Stephan2204/HM-WIRED-ESP32/HM-WIRED-ESP32.ino

#include <Arduino.h>
#include <WiFi.h>
#include <ETH.h>
#include <Network.h>
#include <ESPmDNS.h>
#include <WebServer.h>
#include <Preferences.h>
#include <PubSubClient.h>
#include <Update.h>
#include <nvs.h>
#include <esp_system.h>
#include <time.h>
#include <sys/time.h>
#include <esp_sntp.h>
#include <lwip/ip_addr.h>

HardwareSerial HM485(2);
WebServer webServer(80);
Preferences preferences;
WiFiClient wifiClient;
PubSubClient mqttClient(wifiClient);

// ============================================================
// HM485 PROJECT NOTES / RESEARCH LOG (v0.7.45)
//
// v0.7.43 NEW EVIDENCE / PURPOSE
// - v0.7.42b with A/B connected: every active DBA7/FB probe produced one 0x00
//   roughly one UART character time (~590 us) after DIR was released to RX.
// - v0.7.42b with A/B physically disconnected: 0 RX bytes in all hold-high and
//   turnaround tests. Therefore the 0x00 is bus-side dependent, not a purely local
//   ESP32 UART FIFO echo.
// - Turnaround delays 0..100 us and a 1500 us TX hold did not change the result.
// - v0.7.43 therefore observes GPIO35 (SP485 RO -> ESP32 RX) directly after DIR LOW.
//   It records logic transitions and longest LOW/HIGH runs for 1800 us, then drains
//   the UART FIFO. This distinguishes a real serial byte from a BREAK/long-low or
//   other electrical waveform without depending on HardwareSerial error reporting.
// - IMPORTANT: GPIO sampling is diagnostic only; normal parser/network/MQTT behavior
//   remains based on the stable v0.7.40 lineage.
// ============================================================
//
// IMPORTANT BASELINE
// ------------------
// v0.7.40 is the last known-good normal gateway baseline. It added the
// permanent web-switchable RAW RX ONLY mode. In that mode DIR is forced
// LOW (receive), all WT32 HM485 TX is inhibited, the protocol parser is
// bypassed and every UART byte is logged with timing. KEEP THIS FEATURE
// in all future versions: it is our built-in passive bus analyzer.
//
// HARDWARE / ELECTRICAL FINDINGS
// ------------------------------
// - WT32-ETH01: RX GPIO35, TX GPIO17, DIR GPIO33.
// - Current transceiver is SP485 with DE and /RE controlled together by
//   DIR. The earlier MAX485 setup was replaced during troubleshooting.
// - RX is proven good on the real production bus. v0.7.39 RX-only saw
//   reproducible structured HM485 traffic from real switches and hm485d.
// - Therefore A/B polarity, RX wiring, UART RX pin and 19200 baud work.
// - An isolated self-TX often leaves one 0x00 after TX->RX; treat it as a
//   local turnaround/transceiver artifact unless proven otherwise.
//
// DISCOVERY FINDINGS SO FAR
// -------------------------
// 1. hm485d discovery is a 32-bit tree/prefix search, not a conventional
//    brute-force scan. Passive capture saw 00000000/03, /0B ... /7B, then
//    branches such as 00008000/83, 0000C000/8B and finally
//    the final 32-bit branch split for a known device.
// 2. The user's subnetting analogy is a very useful model: DST is the
//    address/prefix under test and CTRL carries the prefix depth (valid
//    bits). A positive response means at least one device exists below
//    that branch. Exact bit mapping still has to be documented/proven.
// 3. Working hm485d discovery repeats negative/ambiguous probes up to three
//    times. Passive captures show ~20 ms retry timing and progressive tree
//    descent after positive responses.
// 4. Exact hm485d-style discovery frame generation is implemented here:
//    start FD, 4-byte DST, CTRL, no sender for discovery, length 02, CRC16,
//    FC escaping. Known captured frames validated the CRC implementation.
//    FD 00 00 DB A7 FB 02 F8 1A.
// 5. Earlier low-level observations saw raw 0xF8 around known positive
//    prefixes all the way to complete 32-bit device addresses.
// 6. v0.7.41 replayed the complete captured hm485d branch while A/B were
//    still wired with the wrong polarity. All 73 probes produced only 0x00.
//    This result is now INVALID as a protocol conclusion because the later
//    electrical tests proved the bus polarity was wrong for active TX/RX.
// 7. v0.7.42b/.43 isolated that 0x00 electrically. With A/B disconnected
//    it vanished; GPIO35 showed a long invalid level rather than a UART
//    discovery byte. After swapping A/B, the normal active read-only scan
//    works completely: TYPE, SERIAL, FW, EEPROM and STATUS replies are valid
//    for all three known devices. Therefore the current A/B polarity and the
//    normal bidirectional RS485 path are now proven.
// 8. v0.7.44 deliberately returns to the deterministic captured hm485d
//    prefix replay, now with the CORRECT proven A/B polarity. It returned
//    valid F8/F0 positive reactions and 00 negative reactions all the way to
//    a known full-address leaf. v0.7.45 replaced replay with the native full tree.
//    Any non-zero raw reaction is logged; F8 remains counted separately.
//
// v0.7.45 DISCOVERY MILESTONE (PROVEN)
// ------------------------------------
// - Replace the deterministic DBA7 replay with the complete native hm485d
//   32-bit prefix/tree traversal.
// - Start at address 00000000 with validBits=1 and 3 tries per negative prefix.
// - Use CTRL=((validBits-1)<<3)|0x03 exactly like HM485_Protocol.pm.
// - Decide each probe only from the FIRST raw RX byte: 00 = negative; any
//   non-zero byte (normally F8, occasionally observed F0) = positive.
// - Preserve the 20 ms hm485d discovery timeout/step cadence and 600 ms
//   continuous idle guard before starting.
// - On validBits==33, record the full 32-bit device address and continue the
//   tree exactly as hm485d does.
// - After discovery finishes, automatically run the proven READ-ONLY
//   TYPE/SERIAL/FW/EEPROM/STATUS scan against the discovered address list.
// - v0.7.46 retires the fixed TEST_DEVICES runtime fallback. Native discovery
//   is now the normal boot path and the authoritative live address source.

// v0.7.46 CLEANUP / NORMAL-OPERATION STEP
// ----------------------------------------
// - Native discovery starts automatically at boot after 600 ms continuous idle.
// - Normal Serial output is compact: start, FOUND addresses, finish summary,
//   TYPE, SERIAL and FW. Per-prefix discovery, EEPROM dumps and per-channel
//   STATUS lines are disabled by default to reduce jitter and console flooding.
// - Detailed discovery/file and scan logging can be re-enabled with the
//   compile-time flags DISCOVERY_VERBOSE_* / SCAN_VERBOSE_*.
// - EEPROM and STATUS are still queried and processed; only their Serial
//   presentation is quiet. MQTT/state processing remains unchanged.
// - Runtime TEST_DEVICES fallback is retired; discovery results are authoritative.
//
// v0.7.50a POLISH / OPERATIONS
// ---------------------------
// - Persistent German/English selection for the primary web UI. Language never
//   changes MQTT topics, serial-number based object identity or HA unique_id.
// - Common top navigation reduces duplicated buttons and separates normal
//   operation from diagnostics/firmware pages.
// - Authenticated backup export/import for gateway configuration and currently
//   known device metadata (friendly names, profiles, inversion). Backup contains
//   credentials and therefore must be handled as a secret. Discovery remains
//   authoritative after restore.
//
// v0.8.0 OUTPUT CONTROL MILESTONE
// --------------------------------
// - First deliberately write-capable release. The proven v0.7.51 read path,
//   native discovery, RAW RX ONLY hard inhibit and address-conflict guard remain.
// - HMW-IO-12-Sw14-DR digital outputs can be exposed as HA/MQTT Switch or Button.
// - Wire command confirmed from passive FHEM captures: 73 <bus-channel> <value16>,
//   with OFF=0x0000 and ON=0x03FF. Device INFO_LEVEL reply is 69 <ch> <value>.
// - Output writes use bus-idle arbitration and up to three attempts total. A matching
//   INFO_LEVEL reply confirms state; an ACK-only reply is accepted and followed by
//   a status refresh. Failed writes never publish an optimistic state.
// - Button profile supports configurable pulse duration and resting state OFF/ON.
// - Analog/frequency 0..1023 encoding has been observed but is intentionally NOT
//   exposed for writing yet. EEPROM writes remain disabled.
// - Coexistence with another central (for example FHEM 00000001 while this gateway
//   uses 00000002) remains experimental and must be tested carefully.
//
// v0.8.1 WRITE/ACK FIX
// --------------------
// - Fix critical output transaction bug: an active output write no longer blocks
//   sendAck(). Device INFO_LEVEL I-frames are ACKed immediately in the normal
//   parser before output application logic runs. This prevents the device from
//   retransmitting the same 0x69 frame after the missing ACK timeout.
// - AUTO now resolves to OUTPUT_SWITCH for physically known digital outputs.
//   Existing persisted AUTO profiles therefore become switches without NVS migration.


// v0.9.3g5 RELIABILITY / NTP LOGGING
// -----------------------------------
// - Web diagnostic log now keeps monotonic uptime and, after NTP sync, also
//   prepends real local Europe/Berlin timestamps with milliseconds.
// - NTP server is configurable in the web UI. DHCP option 42 can be preferred;
//   a configured manual server remains the fallback. DHCP-NTP is armed from the
//   ETH/WiFi START event, after the TCP/IP stack exists but before the DHCP lease.
// - IMPORTANT g5 fix: SNTP is never initialized before ETH.begin(); this avoids
//   the LAN8720 crash/reboot loop possible in g4.
// - Button output starts rejected by a temporary poll/pending transaction are
//   no longer discarded. They remain queued and retry every 50 ms for up to 10 s.

// GENERAL PROJECT ROADMAP (KEEP THIS SECTION IN FUTURE VERSIONS)
// --------------------------------------------------------------
// DISCOVERY / BUS CORE
// [x] Prove electrical TX/RX path and correct A/B polarity; active reads now work.
// [x] DST+CTRL prefix/valid-bit mapping proven by native full-tree discovery.
// [x] Positive discovery reaction: first RX byte != 0 (hm485d semantics; v0.7.44 verified F8/F0).
// [x] v0.7.45: native hm485d-compatible 32-bit discovery tree implemented.
// [x] v0.7.46: discovered addresses exclusively drive scan/poll; fixed runtime list retired.
// [x] Native discovery automatically hands off to TYPE/SERIAL/FW/EEPROM/STATUS scan.
// [ ] Detect devices appearing/disappearing and expose online/last-seen state.
//
// PASSIVE OPERATION / LEARNING
// [ ] Preserve passive event snooping as the preferred fast state-update path.
// [ ] Passively recognize previously unknown device addresses seen on the bus.
// [ ] Learn/validate channel activity and useful telegram types from traffic.
// [ ] Keep periodic active read-only polling only as a safety/fallback refresh.
// [ ] Keep permanent RAW RX ONLY hard-TX-inhibit mode in every future build.
//
// DEVICE / PORT PROFILE MODEL
// [ ] Build semantic per-channel profiles on top of physical HM485 channels.
// [ ] Profiles planned/needed include at least: Window/door contact, shutter/
//     roller shutter (cover), alarm/contact, switch/light, push button, generic
//     binary input, analog/frequency sensor and generic/raw fallback.
// [ ] Where possible derive electrical/channel capability automatically from
//     device type + EEPROM; allow user override of semantic purpose.
// [ ] Map profiles to correct Home Assistant entity domain/device_class, e.g.
//     binary_sensor, switch, cover, sensor rather than exposing raw channels.
//
// NAMING / CONFIGURATION / PERSISTENCE
// [ ] User-editable friendly name for every device.
// [x] v0.7.47: user-editable friendly name and semantic profile per channel/port.
// [ ] Store names, profile selections, discovered-device metadata and relevant
//     gateway settings persistently in ESP32 NVS (Preferences).
// [ ] Keep configuration across reboot/OTA; design versioned/migratable NVS
//     schema before large numbers of installations/config entries exist.
// [x] v0.7.47: web UI for device/channel naming and profile assignment.
// [x] v0.7.48: per-channel NO/NC inversion, status page, configurable own address.
// [x] v0.7.49: passive address-1 detection + duplicate-own-address TX lock; status shows inversion.
// [x] v0.7.50a: persistent German / English web UI selection.
// [x] v0.7.50a: authenticated config/profile backup export + restore import.
//
// MQTT / HOME ASSISTANT
// [ ] Retained state topics + LWT/availability for gateway and devices.
// [ ] Generate HA MQTT Discovery from the semantic channel profile and names.
// [ ] Update HA immediately from passive bus events; polling is fallback only.
// [ ] Republish discovery/state after MQTT reconnect without duplicate entities.
// [ ] Keep stable unique_ids even if friendly names are changed later.
//
// WRITE / CONTROL - ONLY AFTER READ PATH IS PROVEN
// [ ] Stay READ-ONLY during discovery/profile development.
// [ ] Later add explicit safe switching/control for supported output profiles.
// [ ] Add cover/shutter command semantics only after telegrams are understood.
// [ ] EEPROM writes/configuration only with explicit safeguards, verification,
//     backups and no accidental writes during discovery or passive learning.
// [ ] Separate read-only diagnostics from write-capable operating mode clearly.
//
// PLATFORM / OPERATIONS (ALREADY PRESENT; MUST NOT REGRESS)
// [ ] Ethernet primary on WT32-ETH01; Wi-Fi fallback/setup AP.
// [ ] Web configuration in NVS, HTTP Basic Auth, diagnostics/log page.
// [ ] MQTT, Home Assistant Discovery, retained states and gateway diagnostics.
// [ ] Web OTA firmware update; keep a recoverable serial-flash path.
// [ ] Preserve bus statistics: RX/TX, CRC errors, timeouts, retries, last-seen.
// [ ] Keep experimental/research notes in source until native discovery and
//     stable production operation are proven, so findings are not forgotten.
//
// ============================================================
// HM485 Gateway v0.7.8
//
// Base: v0.5.3a HM485 READ-ONLY core
//
// New:
// - v0.7.46: native discovery runs automatically at boot.
// - Quiet normal logging: discovery probe-by-probe output disabled; status and
//   EEPROM data no longer flood Serial. TYPE/SERIAL/FW remain visible.
// - Fixed TEST_DEVICES list retired from runtime device selection.
//   - WiFi station + fallback setup AP
//   - Web configuration stored in NVS
//   - MQTT + retained states + LWT
//   - Home Assistant MQTT Discovery
//   - Passive HM485 status/event snooping -> immediate MQTT
//   - Periodic read-only status refresh (5 min safety net)
//   - Gateway itself appears as a Home Assistant MQTT device
//   - Gateway diagnostics: firmware, IP, RSSI, uptime, devices,
//     RX/TX frames, CRC errors, timeouts and retries
//   - WT32-ETH01 Ethernet primary + WiFi fallback
//   - Web firmware update (OTA)
//   - HTTP Basic Auth for configuration / OTA
//   - Protected Web Log / Diagnosis page
//   - Optional raw HM485 RX/TX logging in RAM
//   - Native HM485 Discovery diagnostics
//   - Discovery probes grouped as xN
//   - Reactions / CRC errors / incomplete frames correlated to last probe
//   - WT32 sends no HM485 requests while analyzer is active
//
// WT32-ETH01 HM485 wiring:
// GPIO35 = RX <- RO
// GPIO17 = TX -> DI
// GPIO33 = DIR -> RTS / DE+/RE
//
// WT32 Ethernet/LAN8720:
// GPIO16 = PHY oscillator enable
// GPIO18 = MDIO
// GPIO23 = MDC
// GPIO0  = 50 MHz REFCLK input
//
// ESP HM485 address : 00000002
// FHEM central      : 00000001
//
// IMPORTANT:
//   HM485 is still READ ONLY.
//   No output switching and no EEPROM writes.
// ============================================================

// v0.8.2:
// - Data-driven device profile registry for official HMW and selected HBW devices.
// - Explicit support state: tested / known-untested / experimental.
// - Untested/HBW profiles are recognition-only by default: no write enable.
// - Existing tested HMW-IO-12-Sw14-DR write path remains enabled by default.
// v0.9.2:
// - Passive discovery: a CRC-valid frame from a previously unknown device address
//   (> 0x000000FF) schedules automatic identification at the next safe bus-idle slot.
// - Optional experimental runtime writes for documented classic/HBW switch actors.
// v0.9.3g3: HBW-1W-T10 invalid temperatures <= -270.00 degC publish an empty MQTT payload
// so Home Assistant numeric temperature sensors become unknown instead of keeping a bogus value.
// v0.9.3g2: HBW-Sen-EP (0x84) real/source-verified counter payload is
// 69 <channel> <uint16_be>. Counter channels are exposed to HA as numeric
// sensors with state_class=total_increasing and unit 'impulses'. Active polling
// remains disabled for now; passive broadcasts are sufficient for this test.
// v0.9.3g1: compile-order fix: forgetDevice() moved behind transaction
// globals and MQTT forward declarations. No functional changes.
// v0.9.3g: persistent device registry + boot restore/verification, explicit
// 'forget device' action with retained HA discovery cleanup, and extended ESP32
// system diagnostics (chip/RAM/flash/sketch/reset reason). Existing hm485meta
// records are auto-migrated into the registry by enumerating NVS once.
// v0.9.3f4: HBW MQTT resync fix. Every complete 0x41 identity announcement
// now refreshes HA discovery/output subscriptions even when metadata is unchanged.
// A completed targeted HBW status poll republishes retained states as a final
// synchronization pass. This fixes stale HA state and missing /set subscription
// after gateway/HBW restart ordering.
// v0.9.3f3: compile fix: forward declaration of
// processPassiveIdentityStatusPoll() now matches its static definition.
// v0.9.3f2: every HBW 0x41 identity/boot announcement now queues a targeted
// one-shot status poll for that device when activeReadSafe=true. This also
// runs when identity metadata is unchanged, fixing stale HA states after an
// HBW-LC-Sw8 reboot. The queued poll waits for a safe idle bus slot.
// v0.9.3f1: compile/link fix for Arduino auto-prototype const mismatch in
// runtimePollDeviceCount()/runtimePollDeviceAddress(). No protocol changes.
// v0.9.3f: status polling now iterates the runtime device database instead of
// native-discovery-only addresses, so passive HBW devices can be polled when
// their profile explicitly marks active reads safe. HBW-LC-Sw8 is polled via
// 53 ch immediately after its 0x41 identity announcement. HBW-Sen-EP (0x84)
// remains passive-only with eight UINT24 counter channels prepared for testing.
// v0.9.3e: HBW-LC-Sw8 original source verified: LEVEL_SET 78 ch 00/C8,
// LEVEL_GET 53 ch, INFO_LEVEL 69 ch level 00. Active polling enabled.
// 0.9.3d's incorrect 0x69 write path has been removed.
// v0.9.3d: HBW-LC-Sw8 real protocol: 69 ch 00/C8, ACK confirms write;
// overview now shows known state values / nominal channel count.
// v0.9.3c: nominal HBW channel count is independent of active-read safety;
// fixes Web UI channel count and MQTT command subscriptions for HBW actors.
// v0.9.3b: HBW 0x41 identity is learned only in the existing passive
// broadcast path; native discovery remains byte-for-byte/timing unchanged.
// v0.9.3: real HBW support: HBW-1W-T10 (0x81) temperatures and
// HBW-LC-Sw8 (0x83) eight switch channels enabled for hardware verification.
//   Disabled by default and deliberately separate from EEPROM/config support.
//
static constexpr const char *FW_VERSION = "0.9.3g5";

// ============================================================
// Hardware / HM485
// ============================================================

static constexpr int HM485_RX_PIN  = 35;
static constexpr int HM485_TX_PIN  = 17;
static constexpr int HM485_DIR_PIN = 33;
static constexpr uint32_t HM485_BAUD = 19200;

static constexpr uint32_t DEFAULT_LOCAL_ADDRESS = 0x00000001;
static constexpr uint32_t FHEM_ADDRESS  = 0x00000001;

// v0.7.47: no fixed HM485 device addresses are compiled into normal runtime.
// The live device list comes exclusively from native HM485 discovery.

static constexpr uint8_t FRAME_START_LONG  = 0xFD;
static constexpr uint8_t FRAME_START_SHORT = 0xFE;
static constexpr uint8_t ESCAPE_CHAR       = 0xFC;

static constexpr uint32_t BUS_IDLE_US             = 10000;
static constexpr uint32_t RESPONSE_TIMEOUT_MS     = 500;
static constexpr uint32_t REQUEST_GAP_MS          = 100;
static constexpr uint8_t  MAX_REQUEST_RETRIES     = 2;
static constexpr uint32_t STATUS_REFRESH_MS       = 300000;
static constexpr uint32_t MQTT_RECONNECT_MS       = 5000;
static constexpr uint32_t WIFI_CONNECT_TIMEOUT_MS = 15000;
static constexpr uint32_t ETHERNET_FALLBACK_DELAY_MS = 8000;

// v0.7.49 address-collision guard. On every boot the gateway listens only
// before its first HM485 transmission. A source address equal to our own is
// latched as a conflict and keeps DE/TX disabled until the address is changed
// and the gateway is rebooted. Address 00000001 is also observed separately
// so parallel-test installations can see whether the regular central address
// is already active on the bus.
static constexpr uint32_t ADDRESS_GUARD_BOOT_LISTEN_MS = 8000;
static constexpr uint32_t ADDRESS_GUARD_OWN_TX_SUPPRESS_MS = 100;

// v0.7.47: normal operation is intentionally quiet. Detailed per-probe
// discovery logging was invaluable during reverse engineering, but Serial I/O
// and String formatting add jitter. Enable only for diagnostics.
static constexpr bool DISCOVERY_VERBOSE_SERIAL = false;
static constexpr bool DISCOVERY_VERBOSE_FILE   = false;
static constexpr bool SCAN_VERBOSE_STATUS      = false;
static constexpr bool SCAN_VERBOSE_EEPROM      = false;

static constexpr uint8_t  MAX_DEVICES      = 16;
static constexpr uint8_t  MAX_CHANNELS     = 32;
static constexpr uint16_t EEPROM_CACHE_SIZE = 64;

// ============================================================
// Network / MQTT configuration
// ============================================================

struct GatewayConfig
{
  String wifiSsid;
  String wifiPassword;

  String mqttHost;
  uint16_t mqttPort = 1883;
  String mqttUser;
  String mqttPassword;

  String mqttClientId = "hm485-gateway";
  String mqttBaseTopic = "hm485";
  String discoveryPrefix = "homeassistant";
  bool discoveryEnabled = true;

  // v0.9.2: allow runtime writes for documented but locally untested actuators.
  // Default OFF. EEPROM/config writes remain restricted independently.
  bool experimentalWritesEnabled = false;

  String hostname = "hm485-gateway";

  // NTP / clock. DHCP option 42 is preferred when enabled. If DHCP does not
  // supply an NTP server, ntpServer remains the configured fallback.
  bool ntpUseDhcp = true;
  String ntpServer = "";

  // HM485 address of this gateway/central. 00000001 is the regular central
  // address. Other addresses are intended for parallel operation/tests.
  uint32_t localAddress = DEFAULT_LOCAL_ADDRESS;

  // Web UI language. Values: "de" or "en".
  String uiLanguage = "de";

  // HTTP Basic Auth for configuration/OTA.
  String webUser = "admin";
  String webPassword = "hm485setup";
};

GatewayConfig config;

bool setupApActive = false;
String setupApSsid;

bool ethernetStarted = false;
bool wifiFallbackStarted = false;
bool lastEthernetReady = false;
uint32_t ethernetStartedMs = 0;

uint32_t wifiConnectStartedMs = 0;
uint32_t lastMqttReconnectMs = 0;
uint32_t lastGatewayDiagnosticsMs = 0;
static constexpr uint32_t GATEWAY_DIAGNOSTICS_MS = 30000;

// Europe/Berlin with automatic CET/CEST changeover.
static constexpr const char *NTP_TZ = "CET-1CEST,M3.5.0/2,M10.5.0/3";
volatile bool ntpSyncEventPending = false;
volatile bool ntpNetworkGotIpPending = false;
volatile bool ntpDhcpArmed = false;
bool ntpWasSynchronized = false;
bool ntpClientStarted = false;
uint32_t ntpIpReadyMs = 0;

// ============================================================
// HM485 address conflict protection (v0.7.49)
// ============================================================

bool addressGuardBootActive = false;
bool addressConflictLocked = false;
bool centralAddressOneSeen = false;

// Must be declared before web handlers that reference it.
static bool rawRxOnlyMode = false;
uint32_t addressGuardStartedMs = 0;
uint32_t addressConflictLastSeenMs = 0;
uint32_t centralAddressOneLastSeenMs = 0;
uint32_t lastLocalTxCompletedMs = 0;
uint32_t addressConflictSender = 0;

// v0.9.2 passive discovery. Unknown CRC-valid device senders are added as
// candidates and trigger a normal metadata scan once the bus is safely idle.
bool passiveDiscoveryScanPending = false;
uint32_t passiveDiscoveryLastCandidate = 0;

// ============================================================
// Channel model
// ============================================================

enum class ChannelType : uint8_t
{
  UNKNOWN,
  CONTACT,
  DIGITAL_OUTPUT,
  DIGITAL_ANALOG_OUTPUT,
  DIGITAL_INPUT,
  DIGITAL_FREQUENCY_INPUT,
  DIGITAL_ANALOG_INPUT,
  INPUT_OUTPUT,
  COVER,
  DIMMER,
  TEMPERATURE,
  COUNTER,
  KEY_INPUT,
  MOTION,
  RGB
};

enum class ChannelBehaviour : uint8_t
{
  UNKNOWN,
  CONTACT,
  DIGITAL_OUTPUT,
  ANALOG_OUTPUT,
  DIGITAL_INPUT,
  FREQUENCY_INPUT,
  ANALOG_INPUT
};

enum class SemanticProfile : uint8_t
{
  AUTO = 0,
  WINDOW,
  DOOR,
  ALARM,
  CONTACT,
  BINARY_INPUT,
  ANALOG_SENSOR,
  FREQUENCY_SENSOR,
  OUTPUT_MONITOR,
  SHUTTER_MONITOR,
  RAW_SENSOR,
  OUTPUT_SWITCH,
  OUTPUT_BUTTON,
  ANALOG_VOLTAGE_RAW,
  ANALOG_CURRENT_RAW,
  ANALOG_POWER_RAW,
  ANALOG_TEMPERATURE_RAW,
  ANALOG_RESISTANCE_RAW,
  ANALOG_PRESSURE_RAW
};

enum class ValueEncoding : uint8_t
{
  UNKNOWN,
  BOOLEAN_1BYTE,
  BOOLEAN_2BYTE,
  UINT16,
  UINT24
};

enum class PulseValueState : uint8_t
{
  UNAVAILABLE,
  VALID,
  SPECIAL
};

struct BehaviourEeprom
{
  bool available;
  uint16_t byteAddress;
  uint8_t firstBit;
  uint8_t bitStep;
};

struct ChannelProfile
{
  uint8_t first;
  uint8_t count;
  ChannelType type;
  ValueEncoding infoLevelEncoding;
  bool configurable;
  ChannelBehaviour defaultBehaviour;
  BehaviourEeprom behaviourEeprom;
};

enum class DeviceSupport : uint8_t
{
  TESTED,          // Real hardware tested with this gateway
  KNOWN_UNTESTED,  // Profile documented, but no real hardware test here yet
  EXPERIMENTAL     // Homebrew/partial profile; passive/basic recognition only
};

struct DeviceProfile
{
  uint16_t deviceType;
  const char *model;
  const char *family;
  uint16_t eepromSize;
  const ChannelProfile *channels;
  uint8_t channelGroupCount;
  uint8_t nominalChannelCount;
  DeviceSupport support;
  bool activeReadSafe;
  bool writeEnabled;
};

// ============================================================
// Profiles
// ============================================================

static constexpr ChannelProfile PROFILE_SEN_SC_12[] =
{
  { 0, 12, ChannelType::CONTACT, ValueEncoding::BOOLEAN_1BYTE, false,
    ChannelBehaviour::CONTACT, { false, 0, 0, 0 } }
};

static constexpr ChannelProfile PROFILE_IO12_SW14[] =
{
  { 0, 6,  ChannelType::DIGITAL_OUTPUT,          ValueEncoding::BOOLEAN_2BYTE, false, ChannelBehaviour::DIGITAL_OUTPUT, { false, 0, 0, 0 } },
  { 6, 8,  ChannelType::DIGITAL_ANALOG_OUTPUT,   ValueEncoding::UINT16,        true,  ChannelBehaviour::DIGITAL_OUTPUT, { true, 0x0007, 0, 1 } },
  { 14, 6, ChannelType::DIGITAL_FREQUENCY_INPUT, ValueEncoding::BOOLEAN_2BYTE, true,  ChannelBehaviour::DIGITAL_INPUT,  { true, 0x0009, 0, 1 } },
  { 20, 6, ChannelType::DIGITAL_ANALOG_INPUT,    ValueEncoding::UINT16,        true,  ChannelBehaviour::DIGITAL_INPUT,  { true, 0x0008, 0, 1 } }
};

// Generic/untested profile descriptions.  They intentionally do NOT enable
// active writing.  The purpose is recognition, sane HA defaults where safe,
// and a data-driven base for later verified implementations.
static constexpr ChannelProfile PROFILE_IO4_FM[] =
{
  { 0, 4, ChannelType::INPUT_OUTPUT, ValueEncoding::BOOLEAN_1BYTE, true,
    ChannelBehaviour::UNKNOWN, { false, 0, 0, 0 } }
};

static constexpr ChannelProfile PROFILE_SW2[] =
{
  { 0, 2, ChannelType::DIGITAL_OUTPUT, ValueEncoding::BOOLEAN_1BYTE, false,
    ChannelBehaviour::DIGITAL_OUTPUT, { false, 0, 0, 0 } }
};

static constexpr ChannelProfile PROFILE_IO12_SW7[] =
{
  { 0, 7,  ChannelType::DIGITAL_OUTPUT, ValueEncoding::BOOLEAN_1BYTE, false, ChannelBehaviour::DIGITAL_OUTPUT, { false, 0, 0, 0 } },
  { 7, 12, ChannelType::DIGITAL_INPUT,  ValueEncoding::UINT16, false, ChannelBehaviour::DIGITAL_INPUT,  { false, 0, 0, 0 } }
};

static constexpr ChannelProfile PROFILE_DIM1[] =
{
  { 0, 1, ChannelType::DIMMER, ValueEncoding::UINT16, false,
    ChannelBehaviour::UNKNOWN, { false, 0, 0, 0 } }
};

static constexpr ChannelProfile PROFILE_BL1[] =
{
  { 0, 1, ChannelType::COVER, ValueEncoding::UINT16, false,
    ChannelBehaviour::UNKNOWN, { false, 0, 0, 0 } }
};

static constexpr ChannelProfile PROFILE_IO12_FM[] =
{
  { 0, 12, ChannelType::INPUT_OUTPUT, ValueEncoding::UINT16, true,
    ChannelBehaviour::UNKNOWN, { false, 0, 0, 0 } }
};

// HBW-1W-T10, real hardware verified:
 // INFO_LEVEL: 69 <channel 0..9> <temperature MSB> <temperature LSB>
 // temperature is signed int16 big-endian in 0.01 degC.
 // 0x954D = -27315 = -273.15 degC marks an unassigned/missing 1-Wire sensor.
static constexpr ChannelProfile PROFILE_HBW_TEMP10[] =
{
  { 0, 10, ChannelType::TEMPERATURE, ValueEncoding::UINT16, false, ChannelBehaviour::UNKNOWN, { false, 0, 0, 0 } }
};
static constexpr ChannelProfile PROFILE_HBW_BL4[] =
{
  { 0, 4, ChannelType::COVER, ValueEncoding::UINT16, false, ChannelBehaviour::UNKNOWN, { false, 0, 0, 0 } }
};
static constexpr ChannelProfile PROFILE_HBW_BL8[] =
{
  { 0, 8, ChannelType::COVER, ValueEncoding::UINT16, false, ChannelBehaviour::UNKNOWN, { false, 0, 0, 0 } }
};
static constexpr ChannelProfile PROFILE_HBW_SW8[] =
{
  { 0, 8, ChannelType::DIGITAL_OUTPUT, ValueEncoding::BOOLEAN_1BYTE, false, ChannelBehaviour::DIGITAL_OUTPUT, { false, 0, 0, 0 } }
};
static constexpr ChannelProfile PROFILE_HBW_SW12[] =
{
  { 0, 12, ChannelType::DIGITAL_OUTPUT, ValueEncoding::BOOLEAN_1BYTE, false, ChannelBehaviour::DIGITAL_OUTPUT, { false, 0, 0, 0 } }
};
// HBW-Sen-EP (0x84): eight S0/pulse counters.
// Real bus traffic and the original source confirm a 16-bit counter value:
//   INFO_LEVEL: 69 <channel> <value_hi> <value_lo>
// Keep active polling disabled until separately tested on the real module.
static constexpr ChannelProfile PROFILE_HBW_COUNTER8[] =
{
  { 0, 8, ChannelType::COUNTER, ValueEncoding::UINT16, false, ChannelBehaviour::UNKNOWN, { false, 0, 0, 0 } }
};
static constexpr ChannelProfile PROFILE_HBW_KEY8[] =
{
  { 0, 8, ChannelType::KEY_INPUT, ValueEncoding::BOOLEAN_1BYTE, false, ChannelBehaviour::DIGITAL_INPUT, { false, 0, 0, 0 } }
};
static constexpr ChannelProfile PROFILE_HBW_KEY12[] =
{
  { 0, 12, ChannelType::KEY_INPUT, ValueEncoding::BOOLEAN_1BYTE, false, ChannelBehaviour::DIGITAL_INPUT, { false, 0, 0, 0 }
  }
};
static constexpr ChannelProfile PROFILE_HBW_MOTION2[] =
{
  { 0, 2, ChannelType::MOTION, ValueEncoding::BOOLEAN_1BYTE, false, ChannelBehaviour::DIGITAL_INPUT, { false, 0, 0, 0 } }
};
static constexpr ChannelProfile PROFILE_HBW_RGB[] =
{
  { 0, 3, ChannelType::RGB, ValueEncoding::UINT16, false, ChannelBehaviour::UNKNOWN, { false, 0, 0, 0 } }
};

static constexpr DeviceProfile DEVICE_PROFILES[] =
{
  // Official HMW device IDs from the classic HM485 protocol documentation.
  { 0x0010, "HMW-IO-4-FM",       "HMW", 1024, PROFILE_IO4_FM,      1,  4, DeviceSupport::KNOWN_UNTESTED, false, false },
  { 0x0011, "HMW-LC-Sw2-DR",     "HMW", 1024, PROFILE_SW2,         1,  2, DeviceSupport::KNOWN_UNTESTED, false, true  },
  { 0x0012, "HMW-IO-12-Sw7-DR",  "HMW", 1024, PROFILE_IO12_SW7,    2, 19, DeviceSupport::KNOWN_UNTESTED, false, true  },
  { 0x0014, "HMW-LC-Dim1L-DR",   "HMW", 1024, PROFILE_DIM1,        1,  1, DeviceSupport::KNOWN_UNTESTED, false, false },
  { 0x0015, "HMW-LC-Bl1-DR",     "HMW", 1024, PROFILE_BL1,         1,  1, DeviceSupport::KNOWN_UNTESTED, false, false },
  { 0x0016, "HMW-IO-SR-FM",      "HMW", 1024, nullptr,             0,  0, DeviceSupport::KNOWN_UNTESTED, false, false },
  { 0x0019, "HMW-Sen-SC-12-DR",  "HMW", 1024, PROFILE_SEN_SC_12,  1, 12, DeviceSupport::TESTED,         true,  false },
  { 0x001A, "HMW-Sen-SC-12-FM",  "HMW", 1024, PROFILE_SEN_SC_12,  1, 12, DeviceSupport::KNOWN_UNTESTED, false, false },
  { 0x001B, "HMW-IO-12-FM",      "HMW", 1024, PROFILE_IO12_FM,     1, 12, DeviceSupport::KNOWN_UNTESTED, false, false },
  { 0x001C, "HMW-IO-12-Sw14-DR", "HMW", 1024, PROFILE_IO12_SW14,   4, 26, DeviceSupport::TESTED,         true,  true  },

  // HBW/Homebrew IDs from the FHEM Wired overview. These entries are deliberately
  // passive/experimental until a real device or a verified XML profile is tested.
  { 0x0081, "HBW-1W-T10",       "HBW", 0, PROFILE_HBW_TEMP10,   1, 10, DeviceSupport::TESTED,         false, false },
  { 0x0082, "HBW-LC-Bl-4",      "HBW", 0, PROFILE_HBW_BL4,      1,  4, DeviceSupport::EXPERIMENTAL, false, false },
  { 0x0092, "HBW-LC-Bl-8",      "HBW", 0, PROFILE_HBW_BL8,      1,  8, DeviceSupport::EXPERIMENTAL, false, false },
  { 0x0083, "HBW-LC-Sw8",       "HBW", 0, PROFILE_HBW_SW8,      1,  8, DeviceSupport::KNOWN_UNTESTED, true,  true  },
  { 0x0093, "HBW-LC-Sw-12",     "HBW", 0, PROFILE_HBW_SW12,     1, 12, DeviceSupport::EXPERIMENTAL, false, true  },
  { 0x0084, "HBW-Sen-EP",       "HBW", 0, PROFILE_HBW_COUNTER8, 1,  8, DeviceSupport::KNOWN_UNTESTED, false, false },
  { 0x0085, "HBW-Sen-KEY",      "HBW", 0, PROFILE_HBW_KEY8,     1,  8, DeviceSupport::EXPERIMENTAL, false, false },
  { 0x0086, "HBW-Sen-SC8",      "HBW", 0, PROFILE_HBW_KEY8,     1,  8, DeviceSupport::EXPERIMENTAL, false, false },
  { 0x0095, "HBW-Sen-Key-12",   "HBW", 0, PROFILE_HBW_KEY12,    1, 12, DeviceSupport::EXPERIMENTAL, false, false },
  { 0x0091, "HBW-Sec-MDIR-2",   "HBW", 0, PROFILE_HBW_MOTION2,  1,  2, DeviceSupport::EXPERIMENTAL, false, false },
  { 0x00A0, "HBW-LC-RGB1-CV",   "HBW", 0, PROFILE_HBW_RGB,      1,  3, DeviceSupport::EXPERIMENTAL, false, false }
};

static constexpr size_t DEVICE_PROFILE_COUNT =
  sizeof(DEVICE_PROFILES) / sizeof(DEVICE_PROFILES[0]);

// ============================================================
// Runtime devices
// ============================================================

struct ChannelState
{
  bool known = false;
  uint32_t value = 0;
  uint8_t valueSize = 0;

  ChannelBehaviour behaviour = ChannelBehaviour::UNKNOWN;
  bool behaviourKnown = false;

  uint32_t lastUpdate = 0;
};

struct HM485Device
{
  bool used = false;
  uint32_t address = 0;

  bool typeKnown = false;
  uint16_t deviceType = 0;
  const DeviceProfile *profile = nullptr;

  bool serialKnown = false;
  char serialNumber[16] = {};

  bool firmwareKnown = false;
  uint16_t firmware = 0;

  uint8_t eeprom[EEPROM_CACHE_SIZE] = {};
  bool eepromValid[EEPROM_CACHE_SIZE] = {};

  ChannelState channel[MAX_CHANNELS];

  // User metadata is keyed by the dynamically discovered HM485 address and
  // persisted in NVS. It never replaces discovery; it only decorates it.
  bool metadataLoaded = false;
  char friendlyName[32] = {};
  char channelName[MAX_CHANNELS][24] = {};
  SemanticProfile semanticProfile[MAX_CHANNELS] = {};
  // Per-channel logical inversion for NO/NC contacts. This changes the
  // logical MQTT/HA state only; the raw HM485 value remains untouched.
  bool invertLogic[MAX_CHANNELS] = {};
  // v0.8.0 output-button settings. Duration is stored in milliseconds.
  uint32_t buttonPulseMs[MAX_CHANNELS] = {};
  bool buttonRestOn[MAX_CHANNELS] = {};

  uint32_t lastSeen = 0;

  // Restored from persistent metadata at gateway boot. This does NOT mean the
  // device has been seen on the bus in the current boot.
  bool restoredFromNvs = false;
};

HM485Device devices[MAX_DEVICES];

// Forward declaration: used by the web profile handlers before the
// Device DB implementation appears later in this translation unit.
HM485Device *getDevice(uint32_t address, bool create = true);

// Forward declarations used by persistent metadata/web profile helpers.
String hexAddress(uint32_t address);
uint8_t busToHmWiredChannel(uint8_t busChannel);
const DeviceProfile *findDeviceProfile(uint16_t type);
const ChannelProfile *findChannelProfile(const DeviceProfile *device, uint8_t busChannel);
const char *channelTypeName(ChannelType type);
const char *behaviourName(ChannelBehaviour behaviour);
uint8_t deviceChannelCount(const HM485Device *device);

// ============================================================
// Persistent device metadata / semantic channel profiles
// ============================================================

static constexpr uint16_t DEVICE_METADATA_SCHEMA = 3;
static constexpr const char *DEVICE_METADATA_NAMESPACE = "hm485meta";

static constexpr uint16_t DEVICE_REGISTRY_SCHEMA = 1;
static constexpr const char *DEVICE_REGISTRY_KEY = "registry";

struct PersistedDeviceRegistry
{
  uint16_t schema = DEVICE_REGISTRY_SCHEMA;
  uint8_t count = 0;
  uint8_t reserved = 0;
  uint32_t address[MAX_DEVICES] = {};
};

static bool initialNativeDiscoveryFinished = false;
static bool bootKnownDeviceVerifyPending = false;
static uint8_t bootKnownDeviceVerifyIndex = 0;

// v0.7.47 on-flash layout. Kept so existing friendly names/profile settings
// survive the schema extension in v0.7.48.
struct PersistedDeviceMetadataV1
{
  uint16_t schema = 1;
  uint16_t cachedType = 0;
  uint16_t cachedFirmware = 0;
  char cachedSerial[16] = {};
  char friendlyName[32] = {};
  char channelName[MAX_CHANNELS][24] = {};
  uint8_t semanticProfile[MAX_CHANNELS] = {};
};

struct PersistedDeviceMetadataV2
{
  uint16_t schema = 2;
  uint16_t cachedType = 0;
  uint16_t cachedFirmware = 0;
  char cachedSerial[16] = {};
  char friendlyName[32] = {};
  char channelName[MAX_CHANNELS][24] = {};
  uint8_t semanticProfile[MAX_CHANNELS] = {};
  uint8_t invertLogic[MAX_CHANNELS] = {};
};

struct PersistedDeviceMetadata
{
  uint16_t schema = DEVICE_METADATA_SCHEMA;
  uint16_t cachedType = 0;
  uint16_t cachedFirmware = 0;
  char cachedSerial[16] = {};
  char friendlyName[32] = {};
  char channelName[MAX_CHANNELS][24] = {};
  uint8_t semanticProfile[MAX_CHANNELS] = {};
  uint8_t invertLogic[MAX_CHANNELS] = {};
  uint32_t buttonPulseMs[MAX_CHANNELS] = {};
  uint8_t buttonRestOn[MAX_CHANNELS] = {};
};

static const char *semanticProfileName(SemanticProfile profile)
{
  switch (profile)
  {
    case SemanticProfile::WINDOW:           return "Fenster";
    case SemanticProfile::DOOR:             return "Tuer";
    case SemanticProfile::ALARM:            return "Alarm";
    case SemanticProfile::CONTACT:          return "Kontakt";
    case SemanticProfile::BINARY_INPUT:     return "Binaereingang";
    case SemanticProfile::ANALOG_SENSOR:    return "Analogsensor";
    case SemanticProfile::FREQUENCY_SENSOR: return "Frequenzsensor";
    case SemanticProfile::OUTPUT_MONITOR:   return "Ausgang (read-only)";
    case SemanticProfile::SHUTTER_MONITOR:  return "Rollladen (read-only)";
    case SemanticProfile::RAW_SENSOR:       return "Raw Sensor";
    case SemanticProfile::OUTPUT_SWITCH:    return "Ausgang Switch";
    case SemanticProfile::OUTPUT_BUTTON:    return "Ausgang Button";
    case SemanticProfile::ANALOG_VOLTAGE_RAW:     return "Spannung (Rohwert)";
    case SemanticProfile::ANALOG_CURRENT_RAW:     return "Strom (Rohwert)";
    case SemanticProfile::ANALOG_POWER_RAW:       return "Leistung (Rohwert)";
    case SemanticProfile::ANALOG_TEMPERATURE_RAW: return "Temperatur (Rohwert)";
    case SemanticProfile::ANALOG_RESISTANCE_RAW:  return "Widerstand (Rohwert)";
    case SemanticProfile::ANALOG_PRESSURE_RAW:    return "Druck (Rohwert)";
    case SemanticProfile::AUTO:
    default:                                return "Auto";
  }
}

static String deviceMetadataKey(uint32_t address)
{
  // NVS keys are limited to 15 characters. Eight hexadecimal digits fit.
  return hexAddress(address);
}

static void copyStringToBuffer(const String &value, char *buffer, size_t size)
{
  if (!buffer || size == 0)
    return;
  String v = value;
  v.trim();
  if (v.length() >= size)
    v.remove(size - 1);
  v.toCharArray(buffer, size);
}

static String effectiveDeviceName(const HM485Device *device)
{
  if (!device)
    return "HM485";
  if (device->friendlyName[0])
    return String(device->friendlyName);
  if (device->profile && device->serialKnown)
    return String(device->profile->model) + " " + String(device->serialNumber);
  if (device->profile)
    return String(device->profile->model) + " " + hexAddress(device->address);
  return String("HM485 ") + hexAddress(device->address);
}

static String effectiveChannelName(const HM485Device *device, uint8_t busChannel)
{
  if (device && busChannel < MAX_CHANNELS && device->channelName[busChannel][0])
    return String(device->channelName[busChannel]);
  return String("Kanal ") + String(busToHmWiredChannel(busChannel));
}

enum class RuntimeWriteProtocol : uint8_t
{
  NONE,
  SET_73_UINT16_03FF, // HMW-IO-12-Sw14-DR: 73 ch 0000/03FF
  SET_78_UINT8_C8     // classic/HBW switch: 78 ch 00/C8
};

// Explicit prototypes: Arduino's automatic prototype generator can place
// prototypes before this enum, which breaks custom return types.
static bool deviceRuntimeWriteAllowed(const HM485Device *device);
static RuntimeWriteProtocol runtimeWriteProtocol(const HM485Device *device, uint8_t busChannel);

static bool deviceRuntimeWriteAllowed(const HM485Device *device)
{
  if (!device || !device->profile || !device->profile->writeEnabled)
    return false;

  if (device->deviceType == 0x001C)
    return true; // locally tested HMW-IO-12-Sw14-DR

  // Real HBW-LC-Sw8 hardware (type 0x0083) has been physically identified.
  // The original HBW source and FHEM device definition confirm LEVEL_SET 0x78
  // with 0x00/0xC8, LEVEL_GET 0x53 and INFO_LEVEL 0x69. Keep the overall
  // support state KNOWN_UNTESTED until the no-debug hardware switching test
  // has confirmed the complete round trip on this physical module.
  if (device->deviceType == 0x0083)
    return true;

  return config.experimentalWritesEnabled;
}

static RuntimeWriteProtocol runtimeWriteProtocol(const HM485Device *device, uint8_t busChannel)
{
  if (!deviceRuntimeWriteAllowed(device) || !device->profile)
    return RuntimeWriteProtocol::NONE;

  const ChannelProfile *cp = findChannelProfile(device->profile, busChannel);
  if (!cp) return RuntimeWriteProtocol::NONE;

  if (device->deviceType == 0x001C &&
      (cp->type == ChannelType::DIGITAL_OUTPUT ||
       (cp->type == ChannelType::DIGITAL_ANALOG_OUTPUT &&
        device->channel[busChannel].behaviour == ChannelBehaviour::DIGITAL_OUTPUT)))
    return RuntimeWriteProtocol::SET_73_UINT16_03FF;

  // HBW-LC-Sw8 source and FHEM definition confirm:
  //   LEVEL_SET:  78 <channel> <00/C8>
  //   LEVEL_GET:  53 <channel>
  //   INFO_LEVEL: 69 <channel> <00/C8> 00
  switch (device->deviceType)
  {
    case 0x0011: // HMW-LC-Sw2-DR
    case 0x0012: // HMW-IO-12-Sw7-DR, relay outputs only
    case 0x0083: // HBW-LC-Sw8, source verified
    case 0x0093: // HBW-LC-Sw-12
      if (cp->type == ChannelType::DIGITAL_OUTPUT)
        return RuntimeWriteProtocol::SET_78_UINT8_C8;
      break;
    default:
      break;
  }

  return RuntimeWriteProtocol::NONE;
}

static SemanticProfile channelSemanticProfile(const HM485Device *device, uint8_t busChannel)
{
  if (!device || busChannel >= MAX_CHANNELS)
    return SemanticProfile::AUTO;

  uint8_t raw = static_cast<uint8_t>(device->semanticProfile[busChannel]);
  if (raw > static_cast<uint8_t>(SemanticProfile::ANALOG_PRESSURE_RAW))
    raw = static_cast<uint8_t>(SemanticProfile::AUTO);

  SemanticProfile configured = static_cast<SemanticProfile>(raw);
  if (configured != SemanticProfile::AUTO)
    return configured;

  // v0.8.1: AUTO means "Switch" for a channel that is physically known to
  // be a digital output. This also upgrades existing persisted AUTO profiles
  // without rewriting NVS. Configurable digital/analog outputs only become a
  // Switch while their EEPROM-derived behaviour is DIGITAL_OUTPUT.
  if (device->profile)
  {
    const ChannelProfile *cp = findChannelProfile(device->profile, busChannel);
    if (cp)
    {
      if (cp->type == ChannelType::DIGITAL_OUTPUT)
        return deviceRuntimeWriteAllowed(device)
          ? SemanticProfile::OUTPUT_SWITCH
          : SemanticProfile::OUTPUT_MONITOR;
      if (cp->type == ChannelType::DIGITAL_ANALOG_OUTPUT &&
          device->channel[busChannel].behaviour == ChannelBehaviour::DIGITAL_OUTPUT)
        return deviceRuntimeWriteAllowed(device)
          ? SemanticProfile::OUTPUT_SWITCH
          : SemanticProfile::OUTPUT_MONITOR;
    }
  }

  return SemanticProfile::AUTO;
}

static const char *semanticDeviceClass(SemanticProfile profile)
{
  switch (profile)
  {
    case SemanticProfile::WINDOW:  return "window";
    case SemanticProfile::DOOR:    return "door";
    case SemanticProfile::ALARM:   return "problem";
    case SemanticProfile::CONTACT: return "opening";
    default:                       return nullptr;
  }
}

static const char *semanticIcon(SemanticProfile profile)
{
  switch (profile)
  {
    case SemanticProfile::ANALOG_VOLTAGE_RAW:     return "mdi:flash";
    case SemanticProfile::ANALOG_CURRENT_RAW:     return "mdi:current-ac";
    case SemanticProfile::ANALOG_POWER_RAW:       return "mdi:lightning-bolt";
    case SemanticProfile::ANALOG_TEMPERATURE_RAW: return "mdi:thermometer";
    case SemanticProfile::ANALOG_RESISTANCE_RAW:  return "mdi:resistor";
    case SemanticProfile::ANALOG_PRESSURE_RAW:    return "mdi:gauge";
    default:                                       return nullptr;
  }
}

static void saveDeviceMetadata(HM485Device *device);
static void restoreKnownDevicesFromNvs();
static void processBootKnownDeviceVerification();
static bool forgetDevice(uint32_t address);

static void applyLoadedMetadata(HM485Device *device,
                                uint16_t cachedType,
                                uint16_t cachedFirmware,
                                const char *cachedSerial,
                                const char *friendlyName,
                                const char channelName[MAX_CHANNELS][24],
                                const uint8_t semanticProfile[MAX_CHANNELS],
                                const uint8_t *invertLogic,
                                const uint32_t *buttonPulseMs = nullptr,
                                const uint8_t *buttonRestOn = nullptr)
{
  memcpy(device->friendlyName, friendlyName, sizeof(device->friendlyName));
  device->friendlyName[sizeof(device->friendlyName) - 1] = 0;
  memcpy(device->channelName, channelName, sizeof(device->channelName));
  for (uint8_t ch = 0; ch < MAX_CHANNELS; ch++)
  {
    device->channelName[ch][sizeof(device->channelName[ch]) - 1] = 0;
    uint8_t raw = semanticProfile[ch];
    device->semanticProfile[ch] = raw <= static_cast<uint8_t>(SemanticProfile::ANALOG_PRESSURE_RAW)
      ? static_cast<SemanticProfile>(raw)
      : SemanticProfile::AUTO;
    device->invertLogic[ch] = invertLogic ? (invertLogic[ch] != 0) : false;
    device->buttonPulseMs[ch] = buttonPulseMs ? buttonPulseMs[ch] : 2000;
    if (device->buttonPulseMs[ch] < 100) device->buttonPulseMs[ch] = 100;
    if (device->buttonPulseMs[ch] > 3600000UL) device->buttonPulseMs[ch] = 3600000UL;
    device->buttonRestOn[ch] = buttonRestOn ? (buttonRestOn[ch] != 0) : false;
  }

  // Cached identity is informational only; live scan remains authoritative.
  if (cachedType)
  {
    device->typeKnown = true;
    device->deviceType = cachedType;
    device->profile = findDeviceProfile(cachedType);
  }
  if (cachedFirmware)
  {
    device->firmwareKnown = true;
    device->firmware = cachedFirmware;
  }
  if (cachedSerial && cachedSerial[0])
  {
    device->serialKnown = true;
    strncpy(device->serialNumber, cachedSerial, sizeof(device->serialNumber) - 1);
    device->serialNumber[sizeof(device->serialNumber) - 1] = 0;
  }
}


static bool validPersistedDeviceKey(const char *key, uint32_t &address)
{
  if (!key || strlen(key) != 8)
    return false;

  for (uint8_t i = 0; i < 8; i++)
    if (!isxdigit((unsigned char)key[i]))
      return false;

  char *end = nullptr;
  address = strtoul(key, &end, 16);
  return end && *end == 0 && address > 0x000000FFUL && address != 0xFFFFFFFFUL;
}

static bool loadDeviceRegistry(PersistedDeviceRegistry &registry)
{
  registry = PersistedDeviceRegistry{};

  Preferences p;
  if (!p.begin(DEVICE_METADATA_NAMESPACE, true))
    return false;

  const size_t len = p.getBytesLength(DEVICE_REGISTRY_KEY);
  bool ok = false;
  if (len == sizeof(PersistedDeviceRegistry))
  {
    p.getBytes(DEVICE_REGISTRY_KEY, &registry, sizeof(registry));
    ok = registry.schema == DEVICE_REGISTRY_SCHEMA && registry.count <= MAX_DEVICES;
  }
  p.end();

  if (!ok)
    registry = PersistedDeviceRegistry{};

  return ok;
}

static void saveDeviceRegistry(const PersistedDeviceRegistry &registry)
{
  Preferences p;
  if (!p.begin(DEVICE_METADATA_NAMESPACE, false))
    return;

  p.putBytes(DEVICE_REGISTRY_KEY, &registry, sizeof(registry));
  p.end();
}

static void registryAddAddress(uint32_t address)
{
  if (address <= 0x000000FFUL || address == 0xFFFFFFFFUL)
    return;

  PersistedDeviceRegistry registry;
  loadDeviceRegistry(registry);

  for (uint8_t i = 0; i < registry.count; i++)
    if (registry.address[i] == address)
      return;

  if (registry.count >= MAX_DEVICES)
    return;

  registry.address[registry.count++] = address;
  saveDeviceRegistry(registry);
}

static void registryRemoveAddress(uint32_t address)
{
  PersistedDeviceRegistry registry;
  if (!loadDeviceRegistry(registry))
    return;

  uint8_t out = 0;
  for (uint8_t i = 0; i < registry.count; i++)
    if (registry.address[i] != address)
      registry.address[out++] = registry.address[i];

  for (uint8_t i = out; i < MAX_DEVICES; i++)
    registry.address[i] = 0;

  if (out != registry.count)
  {
    registry.count = out;
    saveDeviceRegistry(registry);
  }
}

static bool migrateDeviceRegistryFromMetadataKeys(PersistedDeviceRegistry &registry)
{
  registry = PersistedDeviceRegistry{};

  nvs_iterator_t it = nullptr;
  esp_err_t err = nvs_entry_find("nvs", DEVICE_METADATA_NAMESPACE, NVS_TYPE_BLOB, &it);
  while (err == ESP_OK && it != nullptr)
  {
    nvs_entry_info_t info{};
    nvs_entry_info(it, &info);

    uint32_t address = 0;
    if (validPersistedDeviceKey(info.key, address))
    {
      bool duplicate = false;
      for (uint8_t i = 0; i < registry.count; i++)
        if (registry.address[i] == address)
          duplicate = true;

      if (!duplicate && registry.count < MAX_DEVICES)
        registry.address[registry.count++] = address;
    }

    err = nvs_entry_next(&it);
  }
  nvs_release_iterator(it);

  if (registry.count > 0)
    saveDeviceRegistry(registry);

  return registry.count > 0;
}

static void restoreKnownDevicesFromNvs()
{
  PersistedDeviceRegistry registry;
  bool hadRegistry = loadDeviceRegistry(registry);

  if (!hadRegistry)
  {
    migrateDeviceRegistryFromMetadataKeys(registry);
    if (registry.count > 0)
      webLogAdd(String("[NVS] Migrated device registry entries=") + String(registry.count));
  }

  uint8_t restored = 0;
  for (uint8_t i = 0; i < registry.count && i < MAX_DEVICES; i++)
  {
    const uint32_t address = registry.address[i];
    if (address <= 0x000000FFUL || address == 0xFFFFFFFFUL)
      continue;

    HM485Device *d = getDevice(address, true);
    if (!d)
      continue;

    d->restoredFromNvs = true;
    d->lastSeen = 0; // persisted identity != live bus presence
    restored++;
  }

  if (restored > 0)
  {
    bootKnownDeviceVerifyPending = true;
    bootKnownDeviceVerifyIndex = 0;
    String msg = String("[NVS] Restored known devices=") + String(restored);
    Serial.println(msg);
    webLogAdd(msg);
  }
}

static void loadDeviceMetadata(HM485Device *device)
{
  if (!device || device->metadataLoaded)
    return;

  device->metadataLoaded = true;
  String key = deviceMetadataKey(device->address);
  bool migratedV1 = false;

  Preferences metaPrefs;
  if (!metaPrefs.begin(DEVICE_METADATA_NAMESPACE, true))
    return;

  size_t len = metaPrefs.getBytesLength(key.c_str());
  if (len == sizeof(PersistedDeviceMetadata))
  {
    PersistedDeviceMetadata meta;
    metaPrefs.getBytes(key.c_str(), &meta, sizeof(meta));
    if (meta.schema == DEVICE_METADATA_SCHEMA)
    {
      applyLoadedMetadata(device, meta.cachedType, meta.cachedFirmware,
                          meta.cachedSerial, meta.friendlyName,
                          meta.channelName, meta.semanticProfile,
                          meta.invertLogic, meta.buttonPulseMs, meta.buttonRestOn);
    }
  }
  else if (len == sizeof(PersistedDeviceMetadataV2))
  {
    PersistedDeviceMetadataV2 meta;
    metaPrefs.getBytes(key.c_str(), &meta, sizeof(meta));
    if (meta.schema == 2)
    {
      applyLoadedMetadata(device, meta.cachedType, meta.cachedFirmware,
                          meta.cachedSerial, meta.friendlyName,
                          meta.channelName, meta.semanticProfile, meta.invertLogic);
      migratedV1 = true;
    }
  }
  else if (len == sizeof(PersistedDeviceMetadataV1))
  {
    PersistedDeviceMetadataV1 meta;
    metaPrefs.getBytes(key.c_str(), &meta, sizeof(meta));
    if (meta.schema == 1)
    {
      applyLoadedMetadata(device, meta.cachedType, meta.cachedFirmware,
                          meta.cachedSerial, meta.friendlyName,
                          meta.channelName, meta.semanticProfile, nullptr);
      migratedV1 = true;
    }
  }
  metaPrefs.end();

  // Write the new schema only after the read handle is closed. Existing names
  // and semantic profiles are retained; inversion defaults to off.
  if (migratedV1)
    saveDeviceMetadata(device);
}

static void saveDeviceMetadata(HM485Device *device)
{
  if (!device)
    return;

  PersistedDeviceMetadata meta;
  meta.schema = DEVICE_METADATA_SCHEMA;
  meta.cachedType = device->typeKnown ? device->deviceType : 0;
  meta.cachedFirmware = device->firmwareKnown ? device->firmware : 0;
  if (device->serialKnown)
    memcpy(meta.cachedSerial, device->serialNumber, sizeof(meta.cachedSerial));
  memcpy(meta.friendlyName, device->friendlyName, sizeof(meta.friendlyName));
  memcpy(meta.channelName, device->channelName, sizeof(meta.channelName));
  for (uint8_t ch = 0; ch < MAX_CHANNELS; ch++)
  {
    meta.semanticProfile[ch] = static_cast<uint8_t>(channelSemanticProfile(device, ch));
    meta.invertLogic[ch] = device->invertLogic[ch] ? 1 : 0;
    meta.buttonPulseMs[ch] = device->buttonPulseMs[ch] ? device->buttonPulseMs[ch] : 2000;
    meta.buttonRestOn[ch] = device->buttonRestOn[ch] ? 1 : 0;
  }

  String key = deviceMetadataKey(device->address);
  Preferences metaPrefs;
  if (!metaPrefs.begin(DEVICE_METADATA_NAMESPACE, false))
    return;

  // Avoid an unnecessary flash write if the persisted record is identical.
  PersistedDeviceMetadata oldMeta;
  bool same = false;
  size_t len = metaPrefs.getBytesLength(key.c_str());
  if (len == sizeof(oldMeta))
  {
    metaPrefs.getBytes(key.c_str(), &oldMeta, sizeof(oldMeta));
    same = memcmp(&oldMeta, &meta, sizeof(meta)) == 0;
  }
  if (!same)
    metaPrefs.putBytes(key.c_str(), &meta, sizeof(meta));
  metaPrefs.end();

  registryAddAddress(device->address);
}

static void saveAllDeviceMetadata()
{
  for (uint8_t i = 0; i < MAX_DEVICES; i++)
    if (devices[i].used)
      saveDeviceMetadata(&devices[i]);
}


// ============================================================
// Requests / scanners
// ============================================================

enum class RequestType : uint8_t
{
  NONE,
  REQ_DEVICE_TYPE,
  REQ_SERIAL_NUMBER,
  REQ_FIRMWARE,
  REQ_STATUS,
  REQ_EEPROM_READ
};

struct PendingRequest
{
  bool active = false;
  RequestType type = RequestType::NONE;

  uint32_t target = 0;
  uint8_t txCounter = 0;
  uint8_t channel = 0;

  uint16_t eepromAddress = 0;
  uint8_t eepromLength = 0;

  uint32_t sentAt = 0;
};

PendingRequest pending;

// ============================================================
// v0.8.0 output transaction state
// ============================================================
struct OutputWriteTransaction
{
  bool active = false;
  bool waitingAckOrInfo = false;
  bool verifyPending = false;
  uint32_t target = 0;
  uint8_t channel = 0;
  uint16_t value = 0;
  RuntimeWriteProtocol protocol = RuntimeWriteProtocol::NONE;
  uint8_t txCounter = 0;
  uint8_t attempts = 0;
  uint32_t sentAt = 0;
};

OutputWriteTransaction outputWrite;
static constexpr uint8_t OUTPUT_WRITE_MAX_ATTEMPTS = 3;
static constexpr uint32_t OUTPUT_WRITE_TIMEOUT_MS = 120;
static constexpr uint32_t OUTPUT_VERIFY_DELAY_MS = 40;
static uint32_t outputVerifyDueMs = 0;

struct ButtonPulseState
{
  bool active = false;
  uint32_t deviceAddress = 0;
  uint8_t channel = 0;
  uint32_t dueMs = 0;
  uint32_t durationMs = 2000;
  bool returnOn = false;
  bool startPending = false;
  bool startOn = false;
  uint32_t startQueuedMs = 0;
  uint32_t nextStartRetryMs = 0;
};
ButtonPulseState buttonPulse;

// ============================================================
// v0.9.0 safe EEPROM / I/O configuration transaction
// EEPROM/config writes remain enabled only for the real-hardware-tested HMW-IO-12-Sw14-DR (0x001C).
// The transaction is deliberately narrow: read/modify/write known bytes,
// ACK each write, issue 0x43 apply, then read back and verify.
// ============================================================
enum class IoConfigStage : uint8_t
{
  IDLE,
  WRITE_MODE,
  WRITE_PARAM,
  APPLY,
  VERIFY_MODE_START,
  VERIFY_MODE_WAIT,
  VERIFY_PARAM_START,
  VERIFY_PARAM_WAIT,
  DONE,
  ERROR
};

struct IoConfigTransaction
{
  bool active = false;
  uint32_t target = 0;
  uint8_t channel = 0;
  IoConfigStage stage = IoConfigStage::IDLE;
  bool waitingAck = false;
  uint8_t txCounter = 0;
  uint8_t attempts = 0;
  uint32_t sentAt = 0;

  uint16_t modeAddress = 0;
  uint8_t modeValue = 0;

  bool hasParam = false;
  uint16_t paramAddress = 0;
  uint8_t paramLen = 0;
  uint8_t paramData[2] = {};

  // Optional frequency output setpoint after a successful EEPROM commit.
  bool setFrequencyAfter = false;
  uint16_t frequencyMilliHz = 0;
};

IoConfigTransaction ioConfig;
static constexpr uint8_t IO_CONFIG_MAX_ATTEMPTS = 3;
static constexpr uint32_t IO_CONFIG_ACK_TIMEOUT_MS = 150;

enum class ScanStep : uint8_t
{
  IDLE,
  STEP_TYPE,
  STEP_SERIAL_NUMBER,
  STEP_FIRMWARE,
  STEP_EEPROM0,
  STEP_EEPROM1,
  STEP_STATUS,
  STEP_NEXT_DEVICE,
  DONE
};

bool scanActive = false;
size_t scanDeviceIndex = 0;
ScanStep scanStep = ScanStep::IDLE;
uint8_t scanBusChannel = 0;
uint8_t scanRetry = 0;
uint32_t lastScanActionMs = 0;

bool statusPollActive = false;
size_t statusPollDeviceIndex = 0;
uint8_t statusPollBusChannel = 0;
uint32_t lastStatusPollActionMs = 0;
uint32_t lastStatusRefreshCompletedMs = 0;

// Optional targeted one-device refresh. Manual/global refresh keeps this false.
bool statusPollSingleDevice = false;
uint32_t statusPollSingleAddress = 0;

// A complete HBW 0x41 announcement is also a useful boot/restart indication.
// Queue the refresh instead of transmitting from inside the RX parser.
uint32_t passiveIdentityStatusPollPendingAddress = 0;

// ============================================================
// Statistics
// ============================================================

uint8_t localTxCounter = 0;

uint32_t statRxBytes = 0;
uint32_t statFrames = 0;
uint32_t statCrcOk = 0;
uint32_t statCrcError = 0;
uint32_t statTxFrames = 0;
uint32_t statAckTx = 0;
uint32_t statAckRx = 0;
uint32_t statTimeouts = 0;
uint32_t statRetries = 0;
uint32_t statPassiveUpdates = 0;

volatile uint32_t lastBusActivityUs = 0;

// ============================================================
// Web diagnostic log
// RAM only: no flash wear
// ============================================================

static constexpr uint16_t WEB_LOG_LINES = 160;

String webLogLines[WEB_LOG_LINES];
uint16_t webLogHead = 0;
uint16_t webLogCount = 0;

bool hm485RawLogEnabled = false;

// Passive legacy Discovery Analyzer removed in v0.7.50a.
// Native HM485 Discovery remains available below.

static constexpr uint8_t ACTIVE_DISCOVERY_TRIES = 3;
static constexpr uint32_t ACTIVE_DISCOVERY_TIMEOUT_MS = 20;
static constexpr uint8_t ACTIVE_DISCOVERY_MAX_DEVICES = 32;

struct ActiveDiscoveryState
{
  bool running = false;
  bool waiting = false;
  bool foundAck = false;

  uint32_t address = 0;
  uint8_t validBits = 1;
  uint8_t tries = 0;

  uint32_t nextActionMs = 0;
  uint8_t ackByte = 0;

  uint32_t probeCount = 0;
  uint32_t ackCount = 0;

  // Bytes already sitting in UART RX immediately after our own
  // discovery TX. These are treated as local TX echo / turnaround
  // residue and discarded BEFORE DiscoveryWait starts.
  uint32_t discardedEchoBytes = 0;

  // Complete RX frames that are recognized as our own transmitted
  // HM485 traffic and therefore ignored for discovery.
  uint32_t ignoredOwnFrames = 0;

  // v0.7.8 raw TX-echo matcher. During a discovery probe we remember
  // the exact bytes written to UART. Matching RX bytes are suppressed;
  // the first byte that differs is passed to the hm485d-style raw ACK
  // evaluation.
  static constexpr uint8_t TX_ECHO_MAX = 32;
  uint8_t txEcho[TX_ECHO_MAX] = {};
  uint8_t txEchoLen = 0;
  uint8_t txEchoPos = 0;
  bool txEchoMatching = false;
  uint32_t ignoredEchoBytes = 0;
  uint32_t ignoredEchoFrames = 0;

  // v0.7.9 discovery turnaround diagnostics.  Timestamp is taken
  // immediately after DE is released.  Every first non-echo RX byte
  // is logged with its distance from that point.
  uint32_t rxArmUs = 0;
  uint32_t lastAckDeltaUs = 0;
  uint32_t minAckDeltaUs = 0xFFFFFFFFUL;
  uint32_t maxAckDeltaUs = 0;
  uint8_t diagLogged = 0;
  static constexpr uint8_t DIAG_LOG_MAX = 40;

  // v0.7.12 compact turnaround analyzer
  static constexpr uint8_t ANALYZER_MAX_PROBES = 10;
  static constexpr uint32_t ANALYZER_WINDOW_US = 3000;
  static constexpr uint8_t ANALYZER_MAX_EVENTS = 80;

  struct AnalyzerEvent
  {
    uint8_t probe = 0;
    uint32_t address = 0;
    uint8_t validBits = 0;
    uint8_t value = 0;
    uint32_t deltaUs = 0;
  };

  AnalyzerEvent analyzerEvents[ANALYZER_MAX_EVENTS] = {};
  uint8_t analyzerEventCount = 0;
  uint32_t analyzerDropped = 0;
  uint32_t analyzerPreDeDrained = 0;

  // v0.7.13: measured turnaround guard.
  // v0.7.12 showed local artifacts around 626..675 us and a
  // bus-dependent candidate at 1551 us.
  static constexpr uint32_t DISCOVERY_RX_GUARD_US = 0;
  uint32_t guardIgnored = 0;

  // v0.7.14: The protocol description states that a matching module
  // answers a Discovery probe with exactly one raw byte 0xF8.
  // Other raw bytes are ignored and counted for diagnostics.
  uint32_t nonF8Ignored = 0;

  // v0.7.25: fixed known-positive Discovery probe test.
  static constexpr uint32_t KNOWN_TARGET = 0x00000000UL;
  static constexpr uint8_t KNOWN_CTRL = 0x03;
  static constexpr uint16_t KNOWN_PROBES = 1;
  static constexpr uint8_t KNOWN_TRACE_MAX = 30;
  static constexpr uint8_t SWEEP_STEPS = 1;
  static constexpr uint8_t PROBES_PER_STEP = 1;
  uint16_t turnaroundDelayUs = 0;
  uint16_t sweepSent[SWEEP_STEPS] = {};
  uint16_t sweepF8[SWEEP_STEPS] = {};
  uint16_t sweepF0[SWEEP_STEPS] = {};
  uint16_t sweep00[SWEEP_STEPS] = {};
  uint16_t sweepOther[SWEEP_STEPS] = {};
  uint16_t sweepTimeout[SWEEP_STEPS] = {};

  bool currentProbeHadRx = false;
  bool currentProbeHadF8 = false;
  uint32_t probesWithRx = 0;
  uint32_t probesWithF8 = 0;
  uint32_t probesOtherOnly = 0;
  uint32_t probeTimeouts = 0;
  uint32_t rawByteCount = 0;
  uint16_t rxHistogram[256] = {};

  uint8_t firstRxByte[KNOWN_TRACE_MAX] = {};
  uint32_t firstRxDeltaUs[KNOWN_TRACE_MAX] = {};
  bool firstRxSeen[KNOWN_TRACE_MAX] = {};

  static constexpr uint8_t TREE_TRACE_MAX = 80;
  String treeTrace[TREE_TRACE_MAX];
  uint8_t treeTraceCount = 0;
  uint32_t treeTraceDropped = 0;

  uint32_t foundAddress[ACTIVE_DISCOVERY_MAX_DEVICES] = {};
  uint8_t foundCount = 0;
};

ActiveDiscoveryState activeDiscovery;

static String wireVerifyLastTx;
static String crcAbResultText;

struct PassiveCaptureEvent
{
  uint32_t tUs;
  uint8_t b;
};

static constexpr uint16_t PASSIVE_CAPTURE_MAX = 1536;
static PassiveCaptureEvent passiveCaptureBuf[PASSIVE_CAPTURE_MAX];
static volatile uint16_t passiveCaptureCount = 0;
static volatile uint32_t passiveCaptureDropped = 0;
static volatile bool passiveCaptureActive = false;
static volatile bool passiveCaptureFull = false;
static bool passiveCaptureArmRequested = false;
static uint32_t passiveCaptureArmSinceMs = 0;
static constexpr uint32_t PASSIVE_CAPTURE_ARM_DELAY_MS = 5000;
static uint32_t passiveCaptureStartUs = 0;

// Legacy name retained as generic active-discovery-test ownership gate.
static constexpr uint32_t DISCOVERY_REPLAY_IDLE_US = 600000UL;
static bool quietRootRequested = false;
static void wireVerifySetTx(const uint8_t *data, size_t len)
{
  wireVerifyLastTx = "";
  wireVerifyLastTx.reserve(len * 3 + 16);
  for (size_t i = 0; i < len; i++)
  {
    char b[4];
    snprintf(b, sizeof(b), "%02X", data[i]);
    if (i) wireVerifyLastTx += ' ';
    wireVerifyLastTx += b;
  }
}

// ============================================================
// Forward declarations for upper layers
// ============================================================

void mqttPublishChannel(HM485Device *device, uint8_t busChannel);
void mqttPublishAllStates();
void mqttPublishDiscoveryAll();
void mqttRemoveDeviceDiscovery(HM485Device *device);
void mqttPublishGatewayDiscovery();
void mqttPublishGatewayDiagnostics();
void mqttMessageCallback(char *topic, byte *payload, unsigned int length);
bool startDigitalOutputWrite(HM485Device *device, uint8_t busChannel, bool on);
bool startFrequencyOutputWrite(HM485Device *device, uint8_t busChannel, uint16_t milliHz);
void processOutputWrite();
void processButtonPulse();
void startStatusPoll();
bool startStatusPollForDevice(uint32_t address);
static void processPassiveIdentityStatusPoll();
void startScan();


void activeDiscoveryStart();
void activeDiscoveryStop();
void processActiveDiscovery();
void activeDiscoveryRawByte(uint8_t rawByte);
uint8_t activeDeviceCount();
uint32_t activeDeviceAddress(uint8_t index);
uint8_t runtimePollDeviceCount();
uint32_t runtimePollDeviceAddress(uint8_t index);

static bool forgetDevice(uint32_t address)
{
  HM485Device *device = getDevice(address, false);
  if (!device)
    return false;

  if ((pending.active && pending.target == address) ||
      (outputWrite.active && outputWrite.target == address) ||
      (ioConfig.active && ioConfig.target == address))
    return false;

  // Remove HA retained discovery/state while the serial/key is still known.
  mqttRemoveDeviceDiscovery(device);

  Preferences p;
  if (p.begin(DEVICE_METADATA_NAMESPACE, false))
  {
    p.remove(deviceMetadataKey(address).c_str());
    p.end();
  }
  registryRemoveAddress(address);

  // Remove from runtime DB. It may be learned again later from real bus traffic.
  *device = HM485Device{};

  String msg = String("[DEVICE] Forgotten: ") + hexAddress(address);
  Serial.println(msg);
  webLogAdd(msg);

  if (mqttClient.connected())
  {
    mqttPublishDiscoveryAll();
    mqttSubscribeOutputCommands();
    mqttPublishAllStates();
  }

  return true;
}

// v0.7.42a FIX: forward declaration required by HM485Parser::decodeFrame()
void activeDiscoveryForeignFrame(uint32_t target, uint32_t sender, uint8_t ctrl);
String activeDiscoveryResultText();

// ============================================================
// Web diagnostic log helpers
// ============================================================

String hexAddress(uint32_t address);

void webLogAdd(const String &message)
{
  uint32_t now = millis();
  String prefix;
  prefix.reserve(48);

  // Keep uptime in every line because it is monotonic and invaluable for
  // timing analysis. Once NTP has set a plausible wall clock, prepend local
  // Europe/Berlin date/time including milliseconds as well.
  struct timeval tv;
  gettimeofday(&tv, nullptr);
  if (tv.tv_sec >= 1704067200LL) // 2024-01-01: clock is plausibly synchronized
  {
    struct tm localTm;
    localtime_r(&tv.tv_sec, &localTm);
    char wall[32];
    strftime(wall, sizeof(wall), "%Y-%m-%d %H:%M:%S", &localTm);
    char full[56];
    snprintf(full, sizeof(full), "%s.%03ld [%lu.%03lu] ", wall,
             (long)(tv.tv_usec / 1000L), now / 1000UL, now % 1000UL);
    prefix = full;
  }
  else
  {
    char up[28];
    snprintf(up, sizeof(up), "[uptime %lu.%03lu] ", now / 1000UL, now % 1000UL);
    prefix = up;
  }

  webLogLines[webLogHead] = prefix + message;
  webLogHead = (webLogHead + 1) % WEB_LOG_LINES;
  if (webLogCount < WEB_LOG_LINES) webLogCount++;
}

void webLogClear()
{
  for (uint16_t i = 0; i < WEB_LOG_LINES; i++)
    webLogLines[i] = String();

  webLogHead = 0;
  webLogCount = 0;
}

String webLogText()
{
  String out;
  out.reserve(webLogCount * 110);

  uint16_t start =
    (
      webLogHead +
      WEB_LOG_LINES -
      webLogCount
    ) %
    WEB_LOG_LINES;

  for (uint16_t i = 0; i < webLogCount; i++)
  {
    uint16_t index =
      (start + i) %
      WEB_LOG_LINES;

    out += webLogLines[index];
    out += '\n';
  }

  return out;
}

String hm485RawLine(
  const char *direction,
  uint32_t target,
  uint32_t sender,
  uint8_t ctrl,
  const uint8_t *payload,
  uint8_t payloadLen
)
{
  String line;
  line.reserve(380);

  line += "[RAW ";
  line += direction;
  line += "] DST=";
  line += hexAddress(target);
  line += " SRC=";
  line += hexAddress(sender);

  char tmp[48];
  snprintf(
    tmp,
    sizeof(tmp),
    " CTRL=%02X LEN=%u DATA=",
    ctrl,
    payloadLen
  );

  line += tmp;

  for (uint8_t i = 0; i < payloadLen; i++)
  {
    char hb[4];
    snprintf(
      hb,
      sizeof(hb),
      "%02X",
      payload[i]
    );

    if (i)
      line += ' ';

    line += hb;
  }

  return line;
}

// ============================================================
// Generic helpers
// ============================================================

String hexAddress(uint32_t address)
{
  char buffer[9];
  snprintf(buffer, sizeof(buffer), "%08lX", address);
  return String(buffer);
}

void printAddress(uint32_t address)
{
  Serial.printf("%08lX", address);
}

uint8_t busToHmWiredChannel(uint8_t busChannel)
{
  return busChannel + 1;
}

String twoDigit(uint8_t value)
{
  char b[4];
  snprintf(b, sizeof(b), "%02u", value);
  return String(b);
}

String htmlEscape(const String &src)
{
  String out;
  out.reserve(src.length() + 16);

  for (size_t i = 0; i < src.length(); i++)
  {
    char c = src[i];
    switch (c)
    {
      case '&': out += F("&amp;"); break;
      case '<': out += F("&lt;"); break;
      case '>': out += F("&gt;"); break;
      case '"': out += F("&quot;"); break;
      case '\'': out += F("&#39;"); break;
      default: out += c; break;
    }
  }
  return out;
}

String jsonEscape(const String &src)
{
  String out;
  out.reserve(src.length() + 16);

  for (size_t i = 0; i < src.length(); i++)
  {
    char c = src[i];
    switch (c)
    {
      case '\\': out += F("\\\\"); break;
      case '"':  out += F("\\\""); break;
      case '\n': out += F("\\n"); break;
      case '\r': out += F("\\r"); break;
      case '\t': out += F("\\t"); break;
      default: out += c; break;
    }
  }
  return out;
}

String normalizedTopic(String topic)
{
  topic.trim();

  while (topic.endsWith("/"))
    topic.remove(topic.length() - 1);

  while (topic.startsWith("/"))
    topic.remove(0, 1);

  return topic;
}

// ============================================================
// Configuration / NVS
// ============================================================

void loadConfig()
{
  preferences.begin("hm485gw", true);

  config.wifiSsid        = preferences.getString("wifi_ssid", "");
  config.wifiPassword    = preferences.getString("wifi_pass", "");

  config.mqttHost        = preferences.getString("mqtt_host", "");
  config.mqttPort        = preferences.getUShort("mqtt_port", 1883);
  config.mqttUser        = preferences.getString("mqtt_user", "");
  config.mqttPassword    = preferences.getString("mqtt_pass", "");

  config.mqttClientId    = preferences.getString("mqtt_id", "hm485-gateway");
  config.mqttBaseTopic   = preferences.getString("mqtt_base", "hm485");
  config.discoveryPrefix = preferences.getString("ha_prefix", "homeassistant");
  config.discoveryEnabled = preferences.getBool("ha_disc", true);
  config.experimentalWritesEnabled = preferences.getBool("exp_write", false);
  config.hostname        = preferences.getString("hostname", "hm485-gateway");
  config.ntpUseDhcp      = preferences.getBool("ntp_dhcp", true);
  config.ntpServer       = preferences.getString("ntp_server", "");
  config.localAddress    = preferences.getUInt("hm_addr", DEFAULT_LOCAL_ADDRESS);
  config.uiLanguage      = preferences.getString("ui_lang", "de");

  config.webUser         = preferences.getString("web_user", "admin");
  config.webPassword     = preferences.getString("web_pass", "hm485setup");

  preferences.end();

  config.mqttBaseTopic   = normalizedTopic(config.mqttBaseTopic);
  config.discoveryPrefix = normalizedTopic(config.discoveryPrefix);

  if (config.mqttBaseTopic.length() == 0)
    config.mqttBaseTopic = "hm485";

  if (config.discoveryPrefix.length() == 0)
    config.discoveryPrefix = "homeassistant";

  if (config.mqttClientId.length() == 0)
    config.mqttClientId = "hm485-gateway";

  if (config.hostname.length() == 0)
    config.hostname = "hm485-gateway";

  if (config.localAddress == 0 || config.localAddress == 0xFFFFFFFFUL)
    config.localAddress = DEFAULT_LOCAL_ADDRESS;

  config.uiLanguage.toLowerCase();
  if (config.uiLanguage != "de" && config.uiLanguage != "en")
    config.uiLanguage = "de";

  if (config.webUser.length() == 0)
    config.webUser = "admin";

  if (config.webPassword.length() == 0)
    config.webPassword = "hm485setup";
}

void saveConfig()
{
  preferences.begin("hm485gw", false);

  preferences.putString("wifi_ssid", config.wifiSsid);
  preferences.putString("wifi_pass", config.wifiPassword);

  preferences.putString("mqtt_host", config.mqttHost);
  preferences.putUShort("mqtt_port", config.mqttPort);
  preferences.putString("mqtt_user", config.mqttUser);
  preferences.putString("mqtt_pass", config.mqttPassword);

  preferences.putString("mqtt_id", config.mqttClientId);
  preferences.putString("mqtt_base", config.mqttBaseTopic);
  preferences.putString("ha_prefix", config.discoveryPrefix);
  preferences.putBool("ha_disc", config.discoveryEnabled);
  preferences.putBool("exp_write", config.experimentalWritesEnabled);
  preferences.putString("hostname", config.hostname);
  preferences.putBool("ntp_dhcp", config.ntpUseDhcp);
  preferences.putString("ntp_server", config.ntpServer);
  preferences.putUInt("hm_addr", config.localAddress);
  preferences.putString("ui_lang", config.uiLanguage);

  preferences.putString("web_user", config.webUser);
  preferences.putString("web_pass", config.webPassword);

  preferences.end();
}

// ============================================================
// NTP / wall clock
// ============================================================

static void ntpTimeSyncCallback(struct timeval *tv)
{
  (void)tv;
  // Callback may run from the TCP/IP task. Do not allocate Strings or write
  // the web log here; defer that work to loop().
  ntpSyncEventPending = true;
}

// Network START events happen after the interface/TCP-IP stack exists and before
// DHCP completes. This is the safe place to enable DHCP option 42 on Ethernet.
// Do NOT initialize SNTP here; processNtp() does that later after GOT_IP.
void ntpNetworkEvent(arduino_event_id_t event, arduino_event_info_t info)
{
  (void)info;

  if (event == ARDUINO_EVENT_ETH_START || event == ARDUINO_EVENT_WIFI_STA_START)
  {
    if (config.ntpUseDhcp)
    {
      esp_sntp_servermode_dhcp(true);
      ntpDhcpArmed = true;
    }
    return;
  }

  if (event == ARDUINO_EVENT_ETH_GOT_IP || event == ARDUINO_EVENT_WIFI_STA_GOT_IP)
  {
    ntpNetworkGotIpPending = true;
    return;
  }
}

void setupNtp()
{
  // TZ setup is purely local and is safe before any network interface exists.
  setenv("TZ", NTP_TZ, 1);
  tzset();
  esp_sntp_set_time_sync_notification_cb(ntpTimeSyncCallback);

  // Register before ETH.begin()/WiFi.begin() so START events can arm option 42.
  Network.onEvent(ntpNetworkEvent);

  Serial.printf("[NTP] configured fallback=%s, DHCP option 42=%s\n",
                config.ntpServer.length() ? config.ntpServer.c_str() : "<none>",
                config.ntpUseDhcp ? "enabled" : "disabled");
}

static bool ntpServerSlot0Usable()
{
  const ip_addr_t *addr = esp_sntp_getserver(0);
  if (!addr) return false;
  const char *txt = ipaddr_ntoa(addr);
  if (!txt || !*txt) return false;
  return strcmp(txt, "0.0.0.0") != 0 && strcmp(txt, "::") != 0;
}

void processNtp()
{
  // GOT_IP comes from the network event task; perform all potentially heavier
  // SNTP setup here in the normal Arduino loop. Give DHCP a short moment to
  // finish applying option 42 before deciding whether the manual fallback is needed.
  if (ntpNetworkGotIpPending)
  {
    ntpNetworkGotIpPending = false;
    ntpIpReadyMs = millis();
    ntpClientStarted = false;
  }

  if (!ntpClientStarted && ntpIpReadyMs != 0 && millis() - ntpIpReadyMs >= 250UL)
  {
    if (config.ntpUseDhcp && ntpServerSlot0Usable())
    {
      // DHCP has already populated SNTP server slot 0. Start SNTP without
      // calling configTime/configTzTime, because those would overwrite it.
      esp_sntp_setoperatingmode(SNTP_OPMODE_POLL);
      esp_sntp_init();
      ntpClientStarted = true;

      const ip_addr_t *addr = esp_sntp_getserver(0);
      String src = addr ? String(ipaddr_ntoa(addr)) : String("unknown");
      String msg = String("[NTP] using DHCP option 42 server: ") + src;
      Serial.println(msg);
      webLogAdd(msg);
    }
    else if (config.ntpServer.length() > 0)
    {
      // No DHCP NTP server was received: use the configured fallback.
      configTzTime(NTP_TZ, config.ntpServer.c_str());
      ntpClientStarted = true;
      String msg = String("[NTP] using configured fallback: ") + config.ntpServer;
      Serial.println(msg);
      webLogAdd(msg);
    }
    else
    {
      // No server available. Leave the gateway fully operational; only wall-clock
      // timestamps remain unavailable. Do not repeatedly initialize SNTP.
      ntpClientStarted = true;
      Serial.println(F("[NTP] no server available; continuing with uptime-only logging"));
      webLogAdd("[NTP] no server available; uptime-only logging");
    }
  }

  if (!ntpSyncEventPending) return;
  ntpSyncEventPending = false;

  struct timeval tv;
  gettimeofday(&tv, nullptr);
  if (tv.tv_sec < 1704067200LL) return;

  ntpWasSynchronized = true;
  struct tm localTm;
  localtime_r(&tv.tv_sec, &localTm);
  char stamp[40];
  strftime(stamp, sizeof(stamp), "%Y-%m-%d %H:%M:%S %Z", &localTm);

  String source;
  const char *name = esp_sntp_getservername(0);
  const ip_addr_t *addr = esp_sntp_getserver(0);
  if (name && *name) source = name;
  else if (addr) source = String(ipaddr_ntoa(addr));
  if (!source.length()) source = "unknown";

  String msg = String("[NTP] synchronized: ") + stamp +
               " server=" + source +
               " dhcp42=" + (config.ntpUseDhcp ? "enabled" : "disabled");
  Serial.println(msg);
  webLogAdd(msg);
}

// ============================================================
// WT32-ETH01 Ethernet / network selection
// ============================================================

bool ethernetReady()
{
  return
    ethernetStarted &&
    ETH.linkUp() &&
    ETH.localIP() != IPAddress(0, 0, 0, 0);
}

bool wifiReady()
{
  return WiFi.status() == WL_CONNECTED;
}

bool networkReady()
{
  return ethernetReady() || wifiReady();
}

// Stable local URL independent of the currently active LAN/WiFi IP.
bool mdnsStarted = false;
String mdnsNetwork;

String gatewayConfigurationUrl()
{
  return String("http://") + config.hostname + ".local/";
}

void startMdnsIfNeeded()
{
  // Do not advertise the normal gateway hostname from the setup AP.
  if (!networkReady() || setupApActive)
  {
    if (mdnsStarted)
    {
      MDNS.end();
      mdnsStarted = false;
      mdnsNetwork = "";
    }
    return;
  }

  if (config.hostname.length() == 0)
    return;

  String currentNetwork = ethernetReady() ? "Ethernet" : "WiFi";

  // Re-register when the active transport changes. This keeps the same
  // hostname working after Ethernet <-> WiFi fallback transitions.
  if (mdnsStarted && mdnsNetwork == currentNetwork)
    return;

  if (mdnsStarted)
  {
    MDNS.end();
    mdnsStarted = false;
    mdnsNetwork = "";
    delay(2);
  }

  if (MDNS.begin(config.hostname.c_str()))
  {
    mdnsStarted = true;
    mdnsNetwork = currentNetwork;
    MDNS.addService("http", "tcp", 80);

    Serial.print(F("[mDNS] Ready on "));
    Serial.print(currentNetwork);
    Serial.print(F(": http://"));
    Serial.print(config.hostname);
    Serial.println(F(".local/"));
    webLogAdd(String("[mDNS] Ready on ") + currentNetwork + " http://" + config.hostname + ".local/");
  }
  else
  {
    Serial.println(F("[mDNS] Start failed"));
    webLogAdd("[mDNS] Start failed");
  }
}

String activeNetworkName()
{
  if (ethernetReady())
    return "Ethernet";

  if (wifiReady())
    return "WiFi";

  if (setupApActive)
    return "Setup-AP";

  return "offline";
}

IPAddress activeLocalIP()
{
  if (ethernetReady())
    return ETH.localIP();

  if (wifiReady())
    return WiFi.localIP();

  if (setupApActive)
    return WiFi.softAPIP();

  return IPAddress(0, 0, 0, 0);
}

void startEthernet()
{
  if (ethernetStarted)
    return;

  Serial.println(F("[ETH] Starting WT32-ETH01 LAN8720..."));

  // Arduino-ESP32 3.x signature:
  // ETH.begin(type, phy_addr, mdc, mdio, power, clk_mode)
  bool ok = ETH.begin(
    ETH_PHY_LAN8720,
    1,
    23,
    18,
    16,
    ETH_CLOCK_GPIO0_IN
  );

  ethernetStarted = ok;
  ethernetStartedMs = millis();

  if (!ok)
    Serial.println(F("[ETH] ETH.begin() failed"));
}

// ============================================================
// WiFi
// ============================================================

void startSetupAp()
{
  if (setupApActive)
    return;

  uint64_t chipId = ESP.getEfuseMac();
  char suffix[7];
  snprintf(suffix, sizeof(suffix), "%06llX",
           (unsigned long long)(chipId & 0xFFFFFFULL));

  setupApSsid = "HM485-Gateway-";
  setupApSsid += suffix;

  WiFi.mode(WIFI_AP_STA);

  // Setup-only password. Change later if desired.
  if (WiFi.softAP(setupApSsid.c_str(), "hm485setup"))
  {
    setupApActive = true;

    Serial.println();
    Serial.println(F("[WIFI] Setup AP active"));
    Serial.print(F("[WIFI] SSID : "));
    Serial.println(setupApSsid);
    Serial.println(F("[WIFI] PASS : hm485setup"));
    Serial.print(F("[WIFI] URL  : http://"));
    Serial.println(WiFi.softAPIP());
  }
}

void startWifi()
{
  if (wifiFallbackStarted && WiFi.getMode() != WIFI_OFF)
    return;

  wifiFallbackStarted = true;

  WiFi.persistent(false);
  WiFi.setAutoReconnect(true);
  WiFi.setHostname(config.hostname.c_str());

  if (config.wifiSsid.length() == 0)
  {
    startSetupAp();
    return;
  }

  WiFi.mode(WIFI_STA);

  Serial.print(F("[WIFI] Connecting to "));
  Serial.println(config.wifiSsid);

  WiFi.begin(
    config.wifiSsid.c_str(),
    config.wifiPassword.c_str()
  );

  wifiConnectStartedMs = millis();
}

void processWifi()
{
  if (!wifiFallbackStarted && !setupApActive)
    return;

  static wl_status_t lastStatus = WL_NO_SHIELD;
  wl_status_t current = WiFi.status();

  if (current != lastStatus)
  {
    lastStatus = current;

    if (current == WL_CONNECTED)
    {
      Serial.println();
      Serial.print(F("[WIFI] Connected, IP: "));
      Serial.println(WiFi.localIP());
      Serial.print(F("[WIFI] RSSI: "));
      Serial.println(WiFi.RSSI());
    }
  }

  if (
    config.wifiSsid.length() > 0 &&
    current != WL_CONNECTED &&
    !setupApActive &&
    millis() - wifiConnectStartedMs > WIFI_CONNECT_TIMEOUT_MS
  )
  {
    Serial.println(F("[WIFI] Station timeout, enabling setup AP."));
    startSetupAp();
  }
}

void processNetwork()
{
  bool ethNow = ethernetReady();

  if (ethNow != lastEthernetReady)
  {
    lastEthernetReady = ethNow;

    if (ethNow)
    {
      Serial.println();
      Serial.print(F("[ETH] Link/IP ready: "));
      Serial.println(ETH.localIP());

      webLogAdd(
        String("[NET] Ethernet ready IP=") +
        ETH.localIP().toString()
      );

      // Ethernet is primary. If WiFi was only a fallback, turn the
      // station radio back off. Any MQTT TCP session over WiFi will
      // reconnect automatically through Ethernet.
      if (wifiReady() && !setupApActive)
      {
        Serial.println(F("[NET] Ethernet active -> WiFi fallback off"));
        mqttClient.disconnect();
        WiFi.disconnect(false, false);
        WiFi.mode(WIFI_OFF);
        wifiFallbackStarted = false;
      }
    }
    else
    {
      Serial.println(F("[ETH] Link/IP unavailable"));
      webLogAdd("[NET] Ethernet unavailable");
    }
  }

  // Start WiFi only when Ethernet has not become usable.
  if (
    !ethNow &&
    !wifiFallbackStarted &&
    millis() - ethernetStartedMs >= ETHERNET_FALLBACK_DELAY_MS
  )
  {
    Serial.println(F("[NET] Ethernet unavailable -> starting WiFi fallback"));
    startWifi();
  }

  // Stable .local hostname for both Ethernet and WiFi.
  startMdnsIfNeeded();
}

// ============================================================
// MQTT topic helpers
// ============================================================

String mqttAvailabilityTopic()
{
  return config.mqttBaseTopic + "/gateway/status";
}

String mqttDeviceKey(const HM485Device *device)
{
  if (device && device->serialKnown && strlen(device->serialNumber) > 0)
    return String(device->serialNumber);

  if (device)
    return hexAddress(device->address);

  return "unknown";
}

String mqttStateTopic(const HM485Device *device, uint8_t busChannel)
{
  return config.mqttBaseTopic
       + "/"
       + mqttDeviceKey(device)
       + "/channel/"
       + twoDigit(busToHmWiredChannel(busChannel))
       + "/state";
}

String mqttUniqueId(const HM485Device *device, uint8_t busChannel)
{
  return "hm485_"
       + mqttDeviceKey(device)
       + "_ch"
       + twoDigit(busToHmWiredChannel(busChannel));
}

// ============================================================
// HA entity classification
// ============================================================

bool channelIsBinary(const HM485Device *device, uint8_t busChannel)
{
  if (!device)
    return false;

  switch (channelSemanticProfile(device, busChannel))
  {
    case SemanticProfile::WINDOW:
    case SemanticProfile::DOOR:
    case SemanticProfile::ALARM:
    case SemanticProfile::CONTACT:
    case SemanticProfile::BINARY_INPUT:
    case SemanticProfile::OUTPUT_MONITOR:
    case SemanticProfile::OUTPUT_SWITCH:
    case SemanticProfile::OUTPUT_BUTTON:
      return true;
    case SemanticProfile::ANALOG_SENSOR:
    case SemanticProfile::FREQUENCY_SENSOR:
    case SemanticProfile::SHUTTER_MONITOR:
    case SemanticProfile::RAW_SENSOR:
    case SemanticProfile::ANALOG_VOLTAGE_RAW:
    case SemanticProfile::ANALOG_CURRENT_RAW:
    case SemanticProfile::ANALOG_POWER_RAW:
    case SemanticProfile::ANALOG_TEMPERATURE_RAW:
    case SemanticProfile::ANALOG_RESISTANCE_RAW:
    case SemanticProfile::ANALOG_PRESSURE_RAW:
      return false;
    case SemanticProfile::AUTO:
    default:
      break;
  }

  if (!device->profile)
    return false;

  const ChannelProfile *cp =
    findChannelProfile(device->profile, busChannel);

  if (!cp)
    return false;

  switch (cp->type)
  {
    case ChannelType::CONTACT:
    case ChannelType::DIGITAL_OUTPUT:
      return true;

    case ChannelType::DIGITAL_ANALOG_OUTPUT:
      return device->channel[busChannel].behaviour ==
             ChannelBehaviour::DIGITAL_OUTPUT;

    case ChannelType::DIGITAL_FREQUENCY_INPUT:
      return device->channel[busChannel].behaviour ==
             ChannelBehaviour::DIGITAL_INPUT;

    case ChannelType::DIGITAL_ANALOG_INPUT:
      return device->channel[busChannel].behaviour ==
             ChannelBehaviour::DIGITAL_INPUT;

    case ChannelType::DIGITAL_INPUT:
    case ChannelType::KEY_INPUT:
    case ChannelType::MOTION:
      return true;

    default:
      return false;
  }
}

static bool channelIsWritableOutput(const HM485Device *device, uint8_t busChannel)
{
  if (!device || busChannel >= MAX_CHANNELS || !device->profile) return false;
  if (runtimeWriteProtocol(device, busChannel) == RuntimeWriteProtocol::NONE) return false;
  SemanticProfile sp = channelSemanticProfile(device, busChannel);
  return sp == SemanticProfile::OUTPUT_SWITCH || sp == SemanticProfile::OUTPUT_BUTTON;
}

static bool channelIsFrequencyOutput(const HM485Device *device, uint8_t busChannel)
{
  if (!device || busChannel >= MAX_CHANNELS || !device->profile) return false;
  if (!deviceRuntimeWriteAllowed(device)) return false;
  const ChannelProfile *cp = findChannelProfile(device->profile, busChannel);
  return cp &&
         cp->type == ChannelType::DIGITAL_ANALOG_OUTPUT &&
         device->channel[busChannel].behaviour == ChannelBehaviour::ANALOG_OUTPUT;
}

String mqttCommandTopic(const HM485Device *device, uint8_t busChannel)
{
  return config.mqttBaseTopic + "/" + mqttDeviceKey(device) + "/channel/" +
         twoDigit(busToHmWiredChannel(busChannel)) + "/set";
}

String discoveryComponent(const HM485Device *device, uint8_t busChannel)
{
  SemanticProfile sp = channelSemanticProfile(device, busChannel);
  if (channelIsFrequencyOutput(device, busChannel)) return "number";
  if (sp == SemanticProfile::OUTPUT_SWITCH && channelIsWritableOutput(device, busChannel)) return "switch";
  if (sp == SemanticProfile::OUTPUT_BUTTON && channelIsWritableOutput(device, busChannel)) return "button";
  return channelIsBinary(device, busChannel) ? "binary_sensor" : "sensor";
}

bool channelLogicalOn(const HM485Device *device, uint8_t busChannel)
{
  if (!device || busChannel >= MAX_CHANNELS)
    return false;
  bool on = device->channel[busChannel].value != 0;
  if (device->invertLogic[busChannel])
    on = !on;
  return on;
}

static bool channelIsTemperatureSensor(const HM485Device *device, uint8_t busChannel)
{
  if (!device || !device->profile || busChannel >= MAX_CHANNELS)
    return false;
  const ChannelProfile *cp = findChannelProfile(device->profile, busChannel);
  return cp && cp->type == ChannelType::TEMPERATURE;
}

static int16_t channelTemperatureCentiDegC(const HM485Device *device, uint8_t busChannel)
{
  return static_cast<int16_t>(
    static_cast<uint16_t>(device->channel[busChannel].value & 0xFFFFU)
  );
}

static bool channelTemperatureUnavailable(const HM485Device *device, uint8_t busChannel)
{
  // HBW-1W-T10 uses -273.15 degC as its "no sensor / invalid sensor" marker.
  return channelIsTemperatureSensor(device, busChannel) &&
         channelTemperatureCentiDegC(device, busChannel) <= -27000;
}

// ============================================================
// MQTT publishing
// ============================================================

void mqttPublishAvailability()
{
  if (!mqttClient.connected())
    return;

  String topic = mqttAvailabilityTopic();
  mqttClient.publish(topic.c_str(), "online", true);
}

void mqttPublishChannel(HM485Device *device, uint8_t busChannel)
{
  if (
    !mqttClient.connected() ||
    !device ||
    busChannel >= MAX_CHANNELS ||
    !device->channel[busChannel].known
  )
  {
    return;
  }

  String topic = mqttStateTopic(device, busChannel);
  String payload;

  if (channelIsBinary(device, busChannel))
  {
    payload = channelLogicalOn(device, busChannel)
      ? "ON"
      : "OFF";
  }
  else if (channelIsFrequencyOutput(device, busChannel))
  {
    // HMW wire/status value is milli-Hertz. Home Assistant number uses Hz.
    payload = String(device->channel[busChannel].value / 1000.0f, 3);
  }
  else if (channelIsTemperatureSensor(device, busChannel))
  {
    if (channelTemperatureUnavailable(device, busChannel))
      // HA numeric sensors must not receive the non-numeric string "unknown".
      // An empty MQTT payload makes the state unknown and, when retained,
      // also removes the stale numeric value from the broker.
      payload = "";
    else
      payload = String(channelTemperatureCentiDegC(device, busChannel) / 100.0f, 2);
  }
  else
  {
    payload = String(device->channel[busChannel].value);
  }

  mqttClient.publish(
    topic.c_str(),
    payload.c_str(),
    true
  );
}

void mqttPublishAllStates()
{
  if (!mqttClient.connected())
    return;

  for (uint8_t i = 0; i < MAX_DEVICES; i++)
  {
    HM485Device &d = devices[i];

    if (!d.used)
      continue;

    for (uint8_t ch = 0; ch < MAX_CHANNELS; ch++)
    {
      if (d.channel[ch].known)
        mqttPublishChannel(&d, ch);
    }
  }
}

void mqttPublishDiscoveryChannel(
  HM485Device *device,
  uint8_t busChannel
)
{
  if (
    !mqttClient.connected() ||
    !config.discoveryEnabled ||
    !device ||
    !device->profile ||
    !device->serialKnown
  )
  {
    return;
  }

  const ChannelProfile *cp =
    findChannelProfile(device->profile, busChannel);

  if (!cp)
    return;

  String component =
    discoveryComponent(device, busChannel);

  String uniqueId =
    mqttUniqueId(device, busChannel);

  String discoveryTopic =
    config.discoveryPrefix
    + "/"
    + component
    + "/"
    + uniqueId
    + "/config";

  // A profile change can move the same stable unique_id between HA domains.
  // Remove retained discovery configs from the other domains first, otherwise
  // Home Assistant may keep an orphaned binary_sensor/sensor beside switch/button.
  const char *allComponents[] = {"binary_sensor", "sensor", "switch", "button", "number"};
  for (const char *oldComponent : allComponents)
  {
    if (component == oldComponent) continue;
    String oldTopic = config.discoveryPrefix + "/" + String(oldComponent) + "/" +
                      uniqueId + "/config";
    mqttClient.publish(oldTopic.c_str(), "", true);
  }

  String deviceName = effectiveDeviceName(device);
  String channelName = effectiveChannelName(device, busChannel);

  String payload;
  payload.reserve(900);

  payload += "{";

  payload += "\"name\":\"";
  payload += jsonEscape(channelName);
  payload += "\",";

  payload += "\"unique_id\":\"";
  payload += jsonEscape(uniqueId);
  payload += "\",";

  SemanticProfile semantic = channelSemanticProfile(device, busChannel);
  bool writableOutput = channelIsWritableOutput(device, busChannel);
  bool frequencyOutput = channelIsFrequencyOutput(device, busChannel);
  if (semantic != SemanticProfile::OUTPUT_BUTTON)
  {
    payload += "\"state_topic\":\"";
    payload += jsonEscape(mqttStateTopic(device, busChannel));
    payload += "\",";
  }
  if (writableOutput || frequencyOutput)
  {
    payload += "\"command_topic\":\"";
    payload += jsonEscape(mqttCommandTopic(device, busChannel));
    payload += "\",";
    if (semantic == SemanticProfile::OUTPUT_BUTTON) payload += "\"payload_press\":\"PRESS\",";
  }
  if (frequencyOutput)
  {
    payload += "\"min\":0,";
    payload += "\"max\":65.535,";
    payload += "\"step\":0.001,";
    payload += "\"mode\":\"box\",";
    payload += "\"unit_of_measurement\":\"Hz\",";
  }
  if (channelIsTemperatureSensor(device, busChannel))
  {
    payload += "\"device_class\":\"temperature\",";
    payload += "\"state_class\":\"measurement\",";
    payload += "\"unit_of_measurement\":\"°C\",";
  }
  else if (cp->type == ChannelType::COUNTER)
  {
    // HBW-Sen-EP counters are monotonic during one module runtime and reset
    // when the AVR restarts. Home Assistant's total_increasing state class
    // handles such counter resets.
    payload += "\"state_class\":\"total_increasing\",";
    payload += "\"unit_of_measurement\":\"impulses\",";
    payload += "\"icon\":\"mdi:counter\",";
  }

  payload += "\"availability_topic\":\"";
  payload += jsonEscape(mqttAvailabilityTopic());
  payload += "\",";

  if (channelIsBinary(device, busChannel) && semantic != SemanticProfile::OUTPUT_BUTTON)
  {
    payload += "\"payload_on\":\"ON\",";
    payload += "\"payload_off\":\"OFF\",";
  }

  const char *deviceClass = semanticDeviceClass(channelSemanticProfile(device, busChannel));
  if (deviceClass)
  {
    payload += "\"device_class\":\"";
    payload += deviceClass;
    payload += "\",";
  }

  const char *icon = semanticIcon(channelSemanticProfile(device, busChannel));
  if (icon)
  {
    payload += "\"icon\":\"";
    payload += icon;
    payload += "\",";
  }

  payload += "\"device\":{";

  payload += "\"identifiers\":[\"hm485_";
  payload += jsonEscape(String(device->serialNumber));
  payload += "\"],";

  payload += "\"name\":\"";
  payload += jsonEscape(deviceName);
  payload += "\",";

  payload += "\"model\":\"";
  payload += jsonEscape(String(device->profile->model));
  payload += "\",";

  payload += "\"manufacturer\":\"eQ-3 / Homematic Wired\",";

  payload += "\"configuration_url\":\"";
  payload += jsonEscape(gatewayConfigurationUrl());
  payload += "\",";

  payload += "\"sw_version\":\"";
  char fw[8];
  snprintf(fw, sizeof(fw), "%04X", device->firmware);
  payload += fw;
  payload += "\"";

  payload += "}";

  payload += "}";

  mqttClient.publish(
    discoveryTopic.c_str(),
    payload.c_str(),
    true
  );
}


void mqttRemoveDeviceDiscovery(HM485Device *device)
{
  if (!mqttClient.connected() || !device || !device->serialKnown)
    return;

  const char *allComponents[] = {"binary_sensor", "sensor", "switch", "button", "number"};

  for (uint8_t ch = 0; ch < MAX_CHANNELS; ch++)
  {
    String uniqueId = mqttUniqueId(device, ch);

    for (const char *component : allComponents)
    {
      String topic = config.discoveryPrefix + "/" + String(component) + "/" +
                     uniqueId + "/config";
      mqttClient.publish(topic.c_str(), "", true);
    }

    // Also clear any retained state from this device/channel.
    mqttClient.publish(mqttStateTopic(device, ch).c_str(), "", true);
  }
}

void mqttPublishDiscoveryAll()
{
  if (
    !mqttClient.connected() ||
    !config.discoveryEnabled
  )
  {
    return;
  }

  for (uint8_t i = 0; i < MAX_DEVICES; i++)
  {
    HM485Device &d = devices[i];

    if (
      !d.used ||
      !d.profile ||
      !d.serialKnown
    )
    {
      continue;
    }

    uint8_t count = 0;

    for (uint8_t g = 0; g < d.profile->channelGroupCount; g++)
    {
      uint8_t end =
        d.profile->channels[g].first +
        d.profile->channels[g].count;

      if (end > count)
        count = end;
    }

    for (uint8_t ch = 0; ch < count; ch++)
      mqttPublishDiscoveryChannel(&d, ch);
  }
}


uint8_t detectedDeviceCount()
{
  uint8_t count = 0;

  for (uint8_t i = 0; i < MAX_DEVICES; i++)
  {
    if (devices[i].used && devices[i].typeKnown)
      count++;
  }

  return count;
}

String mqttGatewayTopic(const char *name)
{
  return config.mqttBaseTopic + "/gateway/" + String(name);
}

void mqttPublishGatewaySensorDiscovery(
  const char *objectId,
  const char *name,
  const char *icon = nullptr,
  const char *unit = nullptr,
  const char *deviceClass = nullptr,
  const char *stateClass = nullptr
)
{
  if (!mqttClient.connected() || !config.discoveryEnabled)
    return;

  String uniqueId = "hm485_gateway_" + String(objectId);
  String topic =
    config.discoveryPrefix + "/sensor/" + uniqueId + "/config";

  String payload;
  payload.reserve(900);

  payload += "{";
  payload += "\"name\":\"" + jsonEscape(String(name)) + "\",";
  payload += "\"unique_id\":\"" + jsonEscape(uniqueId) + "\",";
  payload += "\"state_topic\":\"" +
             jsonEscape(mqttGatewayTopic(objectId)) + "\",";
  payload += "\"availability_topic\":\"" +
             jsonEscape(mqttAvailabilityTopic()) + "\",";

  if (icon && strlen(icon))
    payload += "\"icon\":\"" + jsonEscape(String(icon)) + "\",";

  if (unit && strlen(unit))
    payload += "\"unit_of_measurement\":\"" +
               jsonEscape(String(unit)) + "\",";

  if (deviceClass && strlen(deviceClass))
    payload += "\"device_class\":\"" +
               jsonEscape(String(deviceClass)) + "\",";

  if (stateClass && strlen(stateClass))
    payload += "\"state_class\":\"" +
               jsonEscape(String(stateClass)) + "\",";

  payload += "\"entity_category\":\"diagnostic\",";

  payload += "\"device\":{";
  payload += "\"identifiers\":[\"hm485_gateway\"],";
  payload += "\"name\":\"HM485 Gateway\",";
  payload += "\"model\":\"ESP32 HM485 Gateway\",";
  payload += "\"manufacturer\":\"DIY / Homematic Wired\",";
  payload += "\"configuration_url\":\"" + jsonEscape(gatewayConfigurationUrl()) + "\",";
  payload += "\"sw_version\":\"" + jsonEscape(String(FW_VERSION)) + "\"";
  payload += "}";

  payload += "}";

  mqttClient.publish(topic.c_str(), payload.c_str(), true);
}

void mqttPublishGatewayDiscovery()
{
  if (!mqttClient.connected() || !config.discoveryEnabled)
    return;

  mqttPublishGatewaySensorDiscovery(
    "firmware", "Firmware", "mdi:chip"
  );
  mqttPublishGatewaySensorDiscovery(
    "network", "Aktives Netzwerk", "mdi:lan-connect"
  );
  mqttPublishGatewaySensorDiscovery(
    "ip", "IP-Adresse", "mdi:ip-network"
  );
  mqttPublishGatewaySensorDiscovery(
    "rssi", "WLAN RSSI", "mdi:wifi", "dBm",
    "signal_strength", "measurement"
  );
  mqttPublishGatewaySensorDiscovery(
    "uptime", "Uptime", "mdi:timer-outline", "s",
    "duration", "total_increasing"
  );
  mqttPublishGatewaySensorDiscovery(
    "devices", "Erkannte HM-Wired-Geräte", "mdi:devices"
  );
  mqttPublishGatewaySensorDiscovery(
    "rx_frames", "RX Frames", "mdi:download-network-outline"
  );
  mqttPublishGatewaySensorDiscovery(
    "tx_frames", "TX Frames", "mdi:upload-network-outline"
  );
  mqttPublishGatewaySensorDiscovery(
    "crc_errors", "CRC-Fehler", "mdi:alert-circle-outline"
  );
  mqttPublishGatewaySensorDiscovery(
    "timeouts", "Timeouts", "mdi:timer-alert-outline"
  );
  mqttPublishGatewaySensorDiscovery(
    "retries", "Retries", "mdi:reload"
  );
  mqttPublishGatewaySensorDiscovery(
    "passive_updates", "Passive Updates", "mdi:access-point-network"
  );
}

void mqttPublishGatewayDiagnostics()
{
  if (!mqttClient.connected())
    return;

  mqttClient.publish(
    mqttGatewayTopic("firmware").c_str(),
    FW_VERSION,
    true
  );

  String networkName = activeNetworkName();
  mqttClient.publish(
    mqttGatewayTopic("network").c_str(),
    networkName.c_str(),
    true
  );

  String ip =
    networkReady()
      ? activeLocalIP().toString()
      : String("0.0.0.0");

  mqttClient.publish(
    mqttGatewayTopic("ip").c_str(),
    ip.c_str(),
    true
  );

  String rssi =
    wifiReady()
      ? String(WiFi.RSSI())
      : String("0");

  mqttClient.publish(
    mqttGatewayTopic("rssi").c_str(),
    rssi.c_str(),
    true
  );

  String uptime = String(millis() / 1000UL);
  String deviceCount = String(detectedDeviceCount());
  String rxFrames = String(statFrames);
  String txFrames = String(statTxFrames);
  String crcErrors = String(statCrcError);
  String timeouts = String(statTimeouts);
  String retries = String(statRetries);
  String passiveUpdates = String(statPassiveUpdates);

  mqttClient.publish(mqttGatewayTopic("uptime").c_str(), uptime.c_str(), true);
  mqttClient.publish(mqttGatewayTopic("devices").c_str(), deviceCount.c_str(), true);
  mqttClient.publish(mqttGatewayTopic("rx_frames").c_str(), rxFrames.c_str(), true);
  mqttClient.publish(mqttGatewayTopic("tx_frames").c_str(), txFrames.c_str(), true);
  mqttClient.publish(mqttGatewayTopic("crc_errors").c_str(), crcErrors.c_str(), true);
  mqttClient.publish(mqttGatewayTopic("timeouts").c_str(), timeouts.c_str(), true);
  mqttClient.publish(mqttGatewayTopic("retries").c_str(), retries.c_str(), true);
  mqttClient.publish(
    mqttGatewayTopic("passive_updates").c_str(),
    passiveUpdates.c_str(),
    true
  );

  lastGatewayDiagnosticsMs = millis();
}

void mqttSubscribeOutputCommands()
{
  if (!mqttClient.connected()) return;
  for (uint8_t i=0;i<MAX_DEVICES;i++)
  {
    HM485Device &d=devices[i]; if(!d.used || !d.profile || !d.serialKnown) continue;
    uint8_t count=deviceChannelCount(&d);
    for(uint8_t ch=0;ch<count;ch++)
      if(channelIsWritableOutput(&d,ch) || channelIsFrequencyOutput(&d,ch))
        mqttClient.subscribe(mqttCommandTopic(&d,ch).c_str());
  }
}

bool connectMqtt()
{
  if (
    !networkReady() ||
    config.mqttHost.length() == 0
  )
  {
    return false;
  }

  mqttClient.setServer(
    config.mqttHost.c_str(),
    config.mqttPort
  );

  String willTopic =
    mqttAvailabilityTopic();

  bool ok = false;

  if (config.mqttUser.length() > 0)
  {
    ok = mqttClient.connect(
      config.mqttClientId.c_str(),
      config.mqttUser.c_str(),
      config.mqttPassword.c_str(),
      willTopic.c_str(),
      0,
      true,
      "offline"
    );
  }
  else
  {
    ok = mqttClient.connect(
      config.mqttClientId.c_str(),
      willTopic.c_str(),
      0,
      true,
      "offline"
    );
  }

  if (ok)
  {
    Serial.println(F("[MQTT] Connected"));

    webLogAdd(
      String("[MQTT] Connected ") +
      config.mqttHost +
      ":" +
      String(config.mqttPort)
    );

    mqttPublishAvailability();
    mqttPublishGatewayDiscovery();
    mqttPublishGatewayDiagnostics();
    mqttPublishDiscoveryAll();
    mqttSubscribeOutputCommands();
    mqttPublishAllStates();
  }
  else
  {
    Serial.print(F("[MQTT] Connect failed, state="));
    Serial.println(mqttClient.state());
  }

  return ok;
}

void processMqtt()
{
  if (!networkReady())
    return;

  if (!mqttClient.connected())
  {
    if (
      millis() - lastMqttReconnectMs >=
      MQTT_RECONNECT_MS
    )
    {
      lastMqttReconnectMs = millis();
      connectMqtt();
    }

    return;
  }

  mqttClient.loop();

  if (
    millis() - lastGatewayDiagnosticsMs >=
    GATEWAY_DIAGNOSTICS_MS
  )
  {
    mqttPublishGatewayDiagnostics();
  }
}

// ============================================================
// Web authentication
// ============================================================

bool requireWebAuth()
{
  if (
    webServer.authenticate(
      config.webUser.c_str(),
      config.webPassword.c_str()
    )
  )
  {
    return true;
  }

  webServer.requestAuthentication();
  return false;
}

// ============================================================
// Web UI
// ============================================================

static bool uiGerman()
{
  return config.uiLanguage != "en";
}

static const char *T(const char *de, const char *en)
{
  return uiGerman() ? de : en;
}

static String webNav()
{
  String h;
  h.reserve(700);
  h += F("<nav class='topnav'>");
  h += F("<a href='/'>"); h += T("Übersicht", "Overview"); h += F("</a>");
  h += F("<a href='/config'>"); h += T("Konfiguration", "Configuration"); h += F("</a>");
  h += F("<a href='/backup'>"); h += T("Sicherung", "Backup"); h += F("</a>");
  h += F("<a href='/log'>"); h += T("Diagnose", "Diagnostics"); h += F("</a>");
  h += F("<a href='/update'>Firmware</a>");
  h += F("</nav>");
  return h;
}

static const char *semanticProfileLabel(SemanticProfile profile)
{
  switch (profile)
  {
    case SemanticProfile::WINDOW:           return T("Fenster", "Window");
    case SemanticProfile::DOOR:             return T("Tür", "Door");
    case SemanticProfile::ALARM:            return T("Alarm", "Alarm");
    case SemanticProfile::CONTACT:          return T("Kontakt", "Contact");
    case SemanticProfile::BINARY_INPUT:     return T("Binäreingang", "Binary input");
    case SemanticProfile::ANALOG_SENSOR:    return T("Analogsensor", "Analog sensor");
    case SemanticProfile::FREQUENCY_SENSOR: return T("Frequenzsensor", "Frequency sensor");
    case SemanticProfile::OUTPUT_MONITOR:   return T("Ausgang (nur lesen)", "Output (read-only)");
    case SemanticProfile::SHUTTER_MONITOR:  return T("Rollladen (nur lesen)", "Shutter (read-only)");
    case SemanticProfile::RAW_SENSOR:       return T("Raw Sensor", "Raw sensor");
    case SemanticProfile::OUTPUT_SWITCH:    return T("Ausgang: Switch", "Output: switch");
    case SemanticProfile::OUTPUT_BUTTON:    return T("Ausgang: Button/Impuls", "Output: button/pulse");
    case SemanticProfile::ANALOG_VOLTAGE_RAW:     return T("Spannung (Rohwert)", "Voltage (raw)");
    case SemanticProfile::ANALOG_CURRENT_RAW:     return T("Strom (Rohwert)", "Current (raw)");
    case SemanticProfile::ANALOG_POWER_RAW:       return T("Leistung (Rohwert)", "Power (raw)");
    case SemanticProfile::ANALOG_TEMPERATURE_RAW: return T("Temperatur (Rohwert)", "Temperature (raw)");
    case SemanticProfile::ANALOG_RESISTANCE_RAW:  return T("Widerstand (Rohwert)", "Resistance (raw)");
    case SemanticProfile::ANALOG_PRESSURE_RAW:    return T("Druck (Rohwert)", "Pressure (raw)");
    case SemanticProfile::AUTO:
    default:                                return "Auto";
  }
}

String htmlHeader(const String &title)
{
  String html;

  html += F("<!doctype html><html><head>");
  html += F("<meta charset='utf-8'>");
  html += F("<meta name='viewport' content='width=device-width,initial-scale=1'>");
  html += F("<title>");
  html += htmlEscape(title);
  html += F("</title>");
  html += F(
    "<style>"
    "body{font-family:system-ui,sans-serif;max-width:1000px;margin:32px auto;padding:0 16px;background:#f6f7f9;color:#222}"
    "h1,h2{margin-bottom:.4em}"
    ".topnav{display:flex;flex-wrap:wrap;gap:8px;margin:0 0 20px}"
    ".topnav a{background:#fff;border:1px solid #ccc;border-radius:7px;padding:8px 11px;text-decoration:none;color:#222}"
    ".card{background:white;border:1px solid #ddd;border-radius:12px;padding:18px;margin:16px 0}"
    "table{border-collapse:collapse;width:100%}"
    "td,th{text-align:left;padding:7px;border-bottom:1px solid #eee}"
    "input,select{width:100%;box-sizing:border-box;padding:9px;margin:4px 0 12px;border:1px solid #bbb;border-radius:6px;background:white}"
    "input[type=checkbox]{width:auto}"
    "button,.button{display:inline-block;background:#222;color:white;padding:9px 14px;border:0;border-radius:7px;text-decoration:none;cursor:pointer}"
    ".muted{color:#666}"
    ".ok{color:#087a2c;font-weight:600}.bad{color:#a00;font-weight:600}"
    "code{background:#eee;padding:2px 5px;border-radius:4px}"
    "</style>"
  );
  html += F("</head><body>");
  html += webNav();

  return html;
}

String htmlFooter()
{
  return F("</body></html>");
}

String webDeviceTable()
{
  String html;
  html.reserve(5000);

  html += F("<table><tr><th>"); html += T("Adresse", "Address");
  html += F("</th><th>"); html += T("Name", "Name");
  html += F("</th><th>"); html += T("Modell", "Model");
  html += F("</th><th>"); html += T("Seriennummer", "Serial number");
  html += F("</th><th>"); html += T("Statuswerte", "Known states");
  html += F("</th><th></th></tr>");

  for (uint8_t i = 0; i < MAX_DEVICES; i++)
  {
    HM485Device &d = devices[i];
    if (!d.used) continue;

    uint8_t known = 0;
    for (uint8_t ch = 0; ch < MAX_CHANNELS; ch++)
      if (d.channel[ch].known) known++;

    html += F("<tr><td><code>"); html += hexAddress(d.address);
    html += F("</code></td><td>"); html += htmlEscape(effectiveDeviceName(&d));
    html += F("</td><td>"); html += d.profile ? htmlEscape(String(d.profile->model)) : String(T("unbekannt", "unknown"));
    if (d.profile) { html += F("<br><span class='muted'>"); html += htmlEscape(String(deviceSupportName(d.profile->support))); html += F("</span>"); }
    html += F("</td><td>"); html += d.serialKnown ? htmlEscape(String(d.serialNumber)) : String("-");
    html += F("</td><td>");
    html += String(known);
    html += F(" / ");
    html += String(deviceChannelCount(&d));
    html += F("</td><td><a class='button' href='/device?addr="); html += hexAddress(d.address);
    html += F("'>"); html += T("Profile", "Profiles");
    html += F("</a> <a class='button' href='/device_status?addr="); html += hexAddress(d.address);
    html += F("'>"); html += T("Status", "Status"); html += F("</a></td></tr>");
  }

  html += F("</table>");
  return html;
}

static HM485Device *deviceFromWebArg()
{
  if (!webServer.hasArg("addr"))
    return nullptr;
  String value = webServer.arg("addr");
  value.trim();
  if (value.length() != 8)
    return nullptr;
  char *end = nullptr;
  uint32_t address = strtoul(value.c_str(), &end, 16);
  if (!end || *end != 0)
    return nullptr;
  return getDevice(address, false);
}

static bool webChannelFromArgs(HM485Device *&device, uint8_t &ch)
{
  device = deviceFromWebArg();
  if (!device || !webServer.hasArg("ch"))
    return false;
  int ci = webServer.arg("ch").toInt();
  if (ci < 0 || ci >= MAX_CHANNELS)
    return false;
  ch = (uint8_t)ci;
  return findChannelProfile(device->profile, ch) != nullptr;
}

static bool semanticAllowedForBehaviour(SemanticProfile sp, ChannelBehaviour behaviour)
{
  if (sp == SemanticProfile::AUTO)
    return true;
  switch (behaviour)
  {
    case ChannelBehaviour::CONTACT:
    case ChannelBehaviour::DIGITAL_INPUT:
      return sp == SemanticProfile::WINDOW || sp == SemanticProfile::DOOR ||
             sp == SemanticProfile::ALARM || sp == SemanticProfile::CONTACT ||
             sp == SemanticProfile::BINARY_INPUT || sp == SemanticProfile::RAW_SENSOR;
    case ChannelBehaviour::FREQUENCY_INPUT:
      return sp == SemanticProfile::FREQUENCY_SENSOR || sp == SemanticProfile::RAW_SENSOR;
    case ChannelBehaviour::ANALOG_INPUT:
      return sp == SemanticProfile::ANALOG_SENSOR || sp == SemanticProfile::RAW_SENSOR ||
             sp == SemanticProfile::ANALOG_VOLTAGE_RAW ||
             sp == SemanticProfile::ANALOG_CURRENT_RAW ||
             sp == SemanticProfile::ANALOG_POWER_RAW ||
             sp == SemanticProfile::ANALOG_TEMPERATURE_RAW ||
             sp == SemanticProfile::ANALOG_RESISTANCE_RAW ||
             sp == SemanticProfile::ANALOG_PRESSURE_RAW;
    case ChannelBehaviour::DIGITAL_OUTPUT:
      return sp == SemanticProfile::OUTPUT_SWITCH || sp == SemanticProfile::OUTPUT_BUTTON ||
             sp == SemanticProfile::OUTPUT_MONITOR;
    case ChannelBehaviour::ANALOG_OUTPUT: // FHEM name; physically frequency/PWM output
      return sp == SemanticProfile::OUTPUT_MONITOR || sp == SemanticProfile::RAW_SENSOR;
    default:
      return true;
  }
}

static const char *behaviourModeToken(ChannelBehaviour b)
{
  switch (b)
  {
    case ChannelBehaviour::DIGITAL_OUTPUT:  return "do";
    case ChannelBehaviour::ANALOG_OUTPUT:   return "fo";
    case ChannelBehaviour::CONTACT:
    case ChannelBehaviour::DIGITAL_INPUT:   return "di";
    case ChannelBehaviour::FREQUENCY_INPUT: return "fi";
    case ChannelBehaviour::ANALOG_INPUT:    return "ai";
    default:                                return "";
  }
}
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
void loop()
{
  if (rawRxOnlyMode)
  {
    // Hard diagnostic bypass: no parser and no protocol-layer activity.
    digitalWrite(HM485_DIR_PIN, LOW);
    while (HM485.available())
      rawRxOnlyFeed((uint8_t)HM485.read());
    if (rawRxOnlyLine.length() &&
        (uint32_t)(micros() - rawRxOnlyLastByteUs) >= 4000)
      rawRxOnlyFlush();
    processWifi();
    processNetwork();
    processNtp();
    webServer.handleClient();
    digitalWrite(HM485_DIR_PIN, LOW);
    return;
  }

  while (HM485.available())
    parser.feed(HM485.read());

  processAddressGuard();
  checkRequestTimeout();
  processIoConfiguration();
  processOutputWrite();
  processButtonPulse();
  processActiveDiscovery();
  processPassiveDiscovery();
  processPassiveIdentityStatusPoll();
  processPassiveCaptureArm();

  if (passiveCaptureFull)
  {
    passiveCaptureFull = false;
    // Re-enter stop path only to format/dump the already complete buffer.
    passiveCaptureActive = true;
    Serial.println(F("[PASSIVE CAPTURE] FULL - capture stopped, dumping complete buffer"));
    activeDiscoveryStop();
  }

  processScan();
  processStatusPoll();
  processBootKnownDeviceVerification();

  processWifi();
  processNetwork();
  processNtp();
  processMqtt();

  webServer.handleClient();

  handleSerial();

  // Periodic status-only refresh.
  if (
    !scanActive &&
    !statusPollActive &&
    !pending.active &&
    !outputWrite.active &&
    !ioConfig.active &&
    !buttonPulse.active &&
    !quietRootRequested &&
    !passiveCaptureActive &&
    !passiveCaptureArmRequested &&
    millis() -
      lastStatusRefreshCompletedMs >=
      STATUS_REFRESH_MS
  )
  {
    startStatusPoll();
  }
}
