Stephan2204/HM-WIRED-ESP32/(commit log)

2026-09-05 Adding wiring
2026-10-05 Added NTP for correct timestamp and fixed bug with changing outputs during discover
    [HM-WIRED-ESP32.ino]
